DmitriyMakhnovskiy/Digital_BH-meter_NI_DAQ/Design gallery/IMG_20190630_193011_20190701_181841477.jpg

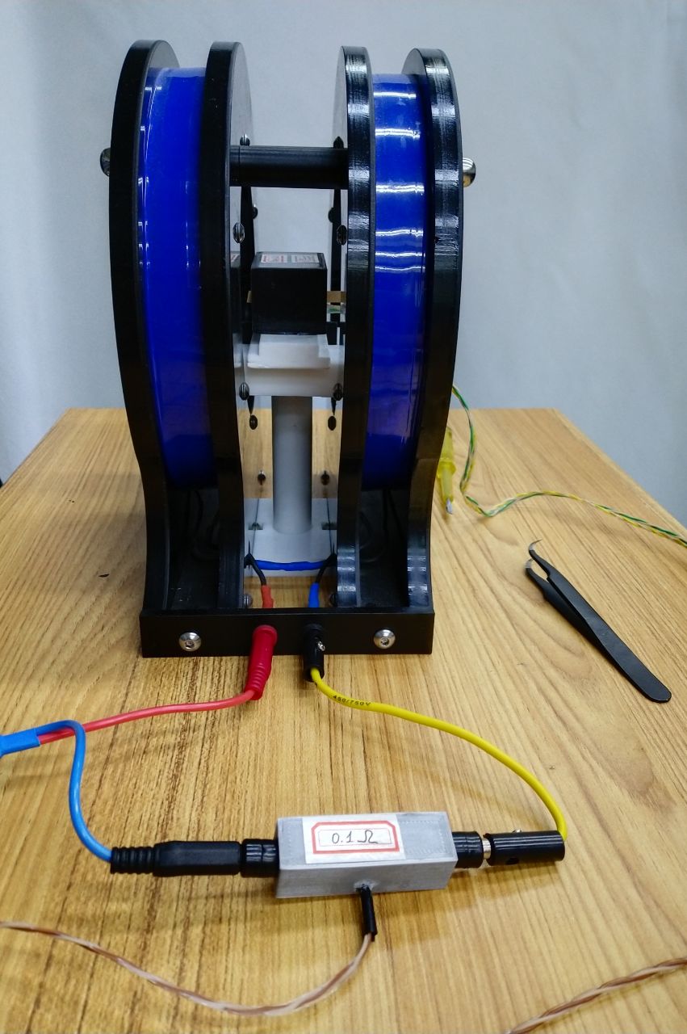
Design gallery/IMG_20190630_193011_20190701_181841477.jpg
