DmitriyMakhnovskiy/Digital_BH-meter_NI_DAQ/Pickup coil design and selection of the devices/Pickup coil design and selection of the devices.pdf

Dmitriy Makhnovskiy | Sensing Materials Technology Ltd, UK | 02.12.2018
1 | P a g e

# Pickup coil design and selection of the devices

## Contents

2 | P a g e

## Measurement setup

The measurement setup for a typical inductive BH looper is shown in Fig. 1. It includes an excitation coil (Helmholtz or solenoid), and two identical solenoidal pickup coils. A current

I
(A; SI units) passed
through the excitation coil induces the magnetising force
H

(Am⁻¹
; SI units) around the pickup coils:
H t | I t ( ) | ( ) =α

(1)

where

α

is a proportionality coefficient (m⁻¹ when using SI units).

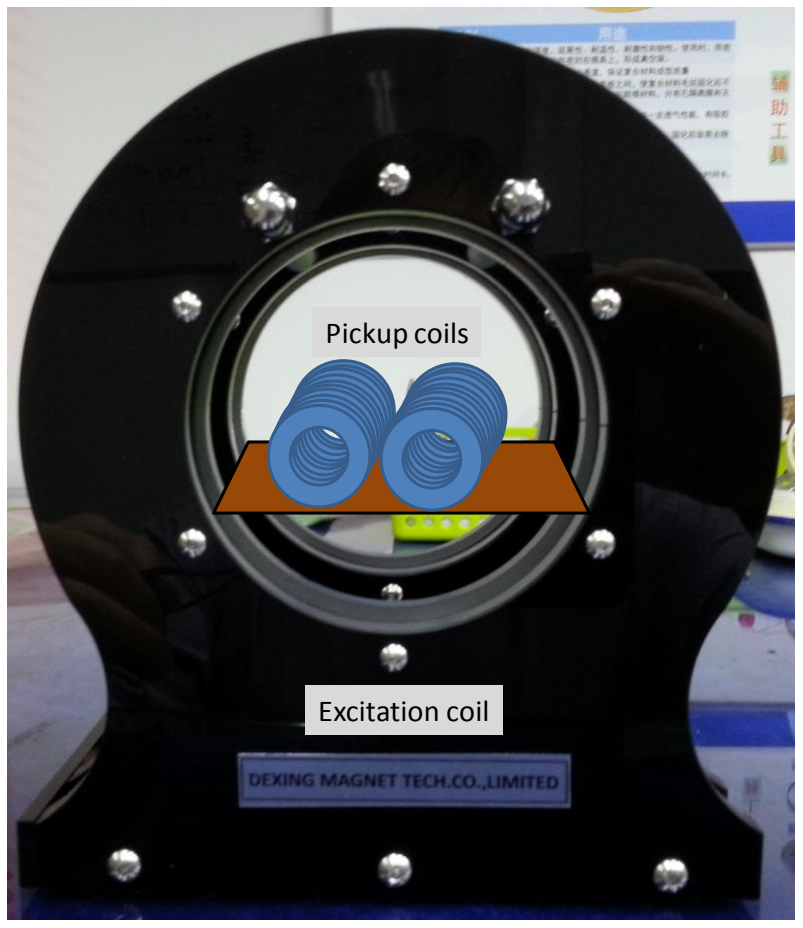
[picture p3: figure]
Excitation coil; Pickup coils

Fig. 1. Measurement setup for an inductive BH looper.

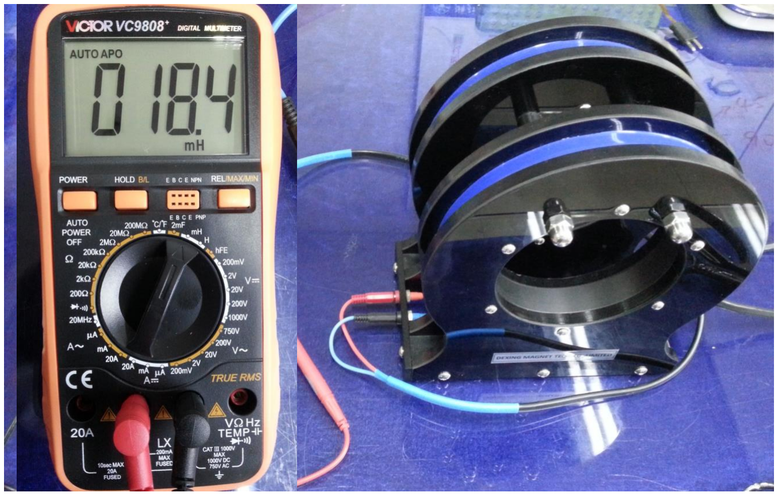
[picture p4: figure]
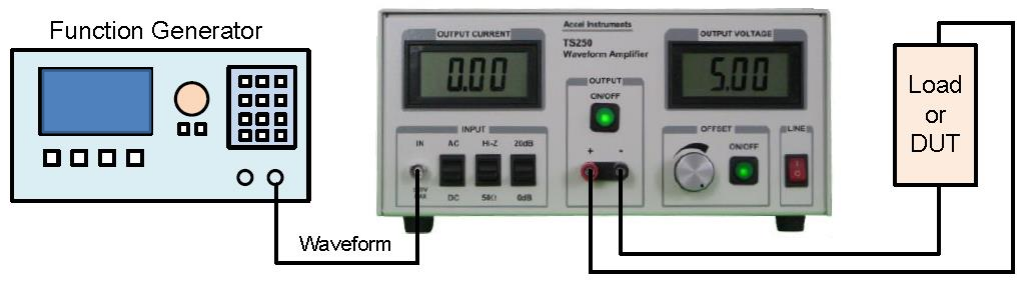
[picture p5: figure]

3 | P a g e

The coil parameters, including its resistance and inductance, can be measured using a digital multimeter (DMM), as shown in Fig. 2.

Fig. 2. Measurement of the coil inductance using a DMM.

## Non-resonant excitation method

In the non-resonant method, the excitation coil (LOAD or DUT), having a resistance

R
(Ω; SI units)
and an inductance

L
(H; SI units), will be connected directly to the waveform amplifier TS250-2 from Accel Instruments (https://www.accelinstruments.com/index.html), as shown in Fig. 3. The waveform will be supplied by our Rohde&Schwartz function generator having the maximum output 10 V at the 50 Ω BNC port.

Fig. 3. Non-resonant excitation method.

4 | P a g e

The main parameters of TS250-2:

- Maximum input voltage ±20 V
- Maximum output voltage ±30 V
- Maximum output currents DC ±2.1 A and AC ±3.0 A (peak)
- Maximum operation frequency 75 kHz
- Voltage gains 1 and 10

For a harmonic excitation voltage

0 V t | V | i t ( ) | exp( | ) = | − ω
, we obtain from (1):

0

exp( | ) () | V | i t Ht
R i L
α | ω ω −
=
+

(2)

where

ωπ = 2 f | is the angular frequency (rads⁻¹
; SI units), V0
is the voltage amplitude (V; SI units), R i L + ω

is the coil impedance. For the selected TS250-2, the maximum amplitude is

0V = 30
V. Let us note that (2) is

true only for a constant or harmonic excitation voltage. In general case, It()

can be expressed through

Vt()
using a convolution.

For the amplitude of the magnetising force (Am⁻¹ ; SI units), we obtain:

-1
| 0
0
2 | 2

[m ]

( ) V
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
3 | -1
| 0
0
2 | 2
10 | [OeA ]
4 | ( | ) V
H
R L

α

π | ω

=
+

(4)

if the excitation coil was calibrated with

-1 α[m ]
or

-1 α[OeA ]
respectively. Using Faraday’s law, for the

voltage

vt()
induced in a one-layer pickup coil, we obtain:
2 | 2 | 2
0 | 0 | 0 ( ) | ( ) | ( ) ( ) | exp( | )
4 | 4 | 4( | )
d | t | D N dB t | D N | dH t | D NV v t | N | i | i t
dt | dt | dt | R i L
π | π | µ | αµ π | ω
ω
ω

Φ
= − | = − | = − | × | = | −
+

(5)

-1
0 | 0 | 2
0
2 | 2
[m ] | ( ) |
4 | ( | )

V
v | v t | ND
R | L
α | µ π ω
| ω
= | =
+

(6)

or

4 | -1
0 | 2
0
2 | 2
10 | [OeA ]
4 | ( | )

V
v | ND
R | L
α | π ω

ω

−
=
+

(7)

5 | P a g e

where
Φ

is the magnetic flux (Wb; SI units) through the pickup coil,
0

v
is the amplitude of the pickup voltage,

N

is the number of turns in the layer,

7
µ | π 0
4 | 10⁻
= | ×

(Hm⁻¹
; SI units) is the permeability of vacuum, and D
is the coil frame diameter. In (5), we assumed that the coil is placed in a homogenous magnetic field.

However, for a multilayer pickup coil, the term
ND

in Eqs. (6),(7) must be modified because for each new layer we will have a slightly different diameter. In addition to D

, let us introduce the coil length l

(m;
SI units), the wire diameter

d
(m; SI units), and the number of fully occupied layers

Nl
. Then, for the number
of turns in each layer we obtain:

N l d = [ / ]
, where the square brackets mean rounding to the integer. Each

layer will add a gradually increasing e.m.f. (from layer to layer) to the total voltage output. So, instead of

2 D
in (6),(7) we have to use the following sum (https://brilliant.org/wiki/sum-of-n-n2-or-n3/):
( | ) | ( | )
1 | 1
2 | 2 | 2 2
0 | 0
1 | 1 | 1
2 | 2 | 2
0 | 0 | 0
| | 2
2
2

2

2

( | 1) | ( | 1)(2 | 1) 1
6
l | l
l | l | l
N | N
n | n
N | N | N
n | n | n
l | l | l
l
D nd | D | Ddn n d
D | Dd | n d | n
d N | d N | N ND
D | D
− | −
= | =
− | − | −
= | = | =
+ | = | + | + | =
æ | ö
= | + | + | = ç | ÷
è | ø
æ | ö − | − | −
= | + | + ç | ÷
è | ø
∑ | ∑
∑ | ∑ | ∑
(8)

Submitting (8) and

N l d = [ / ]
into (6),(7), we obtain for the pickup voltage output:
-1 | | 2
0 | 0 | 2
0
2 | 2 | 2
[m ] | ( | 1) | ( | 1)(2 | 1) | ( ) | | 1
4 | ( | ) | 6
l | l | l
l
V | l | d N | d | N | N v | v t | N D
R | L | d | D | D
α | µ π ω

ω

éù | æ | ö − | − | −
= | = | + | + ç | ÷ êú | ç | ÷
+ | ëû | è | ø

(9)

or

4 | -1 | 2
0 | 2
0
2 | 2 | 2
10 | [OeA ] | ( | 1) | ( | 1)(2 | 1) 1
4 | ( | ) | 6
l | l | l
l
V | l | d N | d | N | N v | N D
R | L | d | D | D
α | π ω

ω

−

éù | æ | ö − | − | −
= | + | + ç | ÷ êú | ç | ÷
+ | ëû | è | ø

(10)

where

[ / ] l
l d N

is the total number of turns in a multilayer pickup coil. Using (8), we can introduce the effective diameter of the pickup coil that must be used for calculating its voltage output together with the total number of turns

[ / ] l
l d N

:

2

2

( | 1) | ( | 1)(2 | 1) 1
6
l | l | l
eff
d N | d | N | N D | D
D | D
− | − | −
= | + | +

(11)

For
Nl =1

, we obviously have

D | D eff = | .

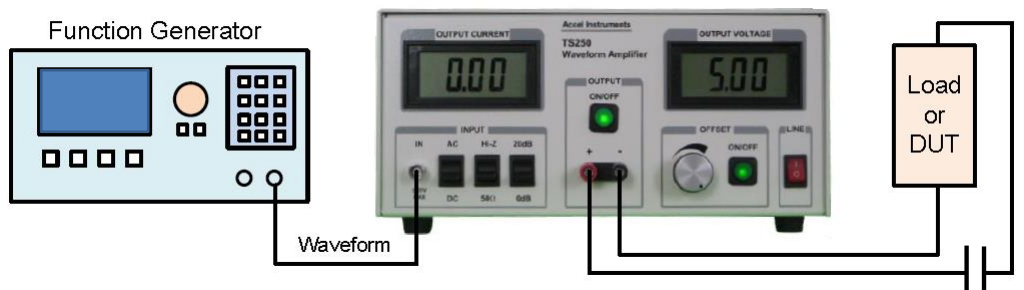
[picture p6: figure]

6 | P a g e

## Resonance excitation

In the resonance excitation method shown in Fig. 4, an additional capacitor C

(Farad; Si units) is
connected in series with the coil to compensate the inductive part of its impedance:

1
Z R i L ()
C
ω | ω
ω
æ | ö
= + | − ç | ÷ è | ø

(12)

The current resonance condition means that

1/ | 0 L | C ω | ω res | res
− | =
:

1
res | LC
ω | =

(13)

At the resonance, the coil impedance becomes purely real

( | ) Z | R ωres
= .

Fig. 4. Resonance excitation method with an additional capacitor connected in series with the coil.

Further reading: https://www.accelinstruments.com/Applications/WaveformAmp/Electromagnetic-Coil-Resonant.html (https://www.accelinstruments.com/Applications/WaveformAmp/Electromagnetic-Coil-Resonant.html)

Using (9),(10), we obtain at the resonance condition:

-1 | 2
0 | 0 | 2
0 | 2
[m ] | ( | 1) | ( | 1)(2 | 1) 1
4 | | | | 6
l | l | l
l
V | l | d N | d | N | N v | N D
R | d | D | D
α | µ π ω éù | æ | ö − | − | −
= | + | + ç | ÷ êú | ç | ÷ ëû | è | ø
(14)

or

4 | -1 | 2
0 | 2
0 | 2
10 | [OeA ] | ( | 1) | ( | 1)(2 | 1) 1
| 4 | | | | 6
l | l | l
l
V | l | d N | d | N | N v | N D
R | d | D | D
α | π ω ⁻
éù | æ | ö − | − | −
= | + | + ç | ÷ êú | ç | ÷ ëû | è | ø
(15)

C

7 | P a g e

Other parameters:

-1
0
0

[m ]V
H
R

α
=
(14)

or

3 | -1
0
0
10 | [OeA ]
| 4 V
H
| R

α
π

=

(15)

0 | 0 | res
C
res
V | V L V
RC | R ω
ω
= | =

(16)

2

1

res

C
Lω

=

(17)

where

VC
is the voltage amplitude across the capacitor. The magnitude of

VC
is important to select the proper voltage rate (kV) of the capacitor. We will use high voltage capacitors.

## Performance of the excitation and pickup coils vs frequency

The algorithm in Fortran used for analysing the excitation and pickup coils is shown below. It was compiled as a console application (PickupCoil.exe) and combines all equations derived above.

### Fortran code

INTEGER flag,i,N,Nl
DOUBLE PRECISION pi,R,L,V0,v,vind,vres,maxf,f,df,mu0,Z,Iex DOUBLE PRECISION VC,C,a,H1,H2,D,lc,dw,startfres,stopfres PARAMETER(pi=3.1415926535897932384626433832795, N=5000)

mu0=4.0*pi*1.0E-7

WRITE(*,*)'Enter the resistance of the excitation coil (Ohm).' READ(*,*) R
WRITE(*,*)''

WRITE(*,*)'Enter the inductance of the excitation coil (mH).' READ(*,*) L
WRITE(*,*)''
L=L*1.0E-3

WRITE(*,*)'Enter the diameter of the pickup coil (mm).' READ(*,*) D
WRITE(*,*)''
D=D*1.0E-3

WRITE(*,*)'Enter the length of the pickup coil (mm).' READ(*,*) lc
WRITE(*,*)''
lc=lc*1.0E-3

8 | P a g e

WRITE(*,*)'Enter the wire diameter used in the pickup coil (mm).' READ(*,*) dw
WRITE(*,*)''
dw=dw*1.0E-3

WRITE(*,*)'Enter the number of layers in the pickup coil.' READ(*,*) Nl
WRITE(*,*)''

WRITE(*,*)'Enter the amplitude of the excitation voltage (V).' READ(*,*) V0
WRITE(*,*)''

WRITE(*,*)'Enter the maximum excitation frequency (Hz).' READ(*,*) maxf
WRITE(*,*)''

WRITE(*,*)'Enter the start resonance frequency (Hz).' READ(*,*) startfres
WRITE(*,*)''

WRITE(*,*)'Enter the stop resonance frequency (Hz).' READ(*,*) stopfres
WRITE(*,*)''

df=maxf/N
OPEN(10,FILE='Excitation_coil_impedance.CSV') WRITE(10,*)'Hertz',',','Ohm'
DO i=0,N
f=df*i
Z=DSQRT(R**2+(2.0*pi*f*L)**2) WRITE(10,100) f,Z
END DO
CLOSE(10)
100 | FORMAT(F20.8,',',F20.8)
| df=(stopfres-startfres)/N
| OPEN(20,FILE='Resonance_capacitor.CSV')
| WRITE(20,*)'Hertz',',','Farad',',','V across C'
| DO i=0,N
| f=startfres+df*i
| C=1.0/(L*(2.0*pi*f)**2)
| VC=V0*L*2.0*pi*f/R
| WRITE(20,200) f,C,VC
| END DO
| CLOSE(20)
200 | FORMAT(F20.8,',',F20.20,',',F20.8)
| WRITE(*,*)'Units for the coil calibration coefficient H=a*I:'
| WRITE(*,*)'Enter 1 for a[1/m]'
| WRITE(*,*)'Enter 2 for a[Oe/A]'
| READ(*,*) flag
| WRITE(*,*)''

9 | P a g e

df=maxf/N

OPEN(25,FILE='Excitation_current.CSV') WRITE(25,*)'Hz',',','A'
DO i=0,N
f=df*i
Iex=V0/DSQRT(R**2+(2.0*pi*f*L)**2) WRITE(25,250) f,Iex
END DO
CLOSE(25)
250 | FORMAT(F20.8,',',F20.8)
c | *********************************************
| SELECT CASE(flag)
| CASE(1)
| WRITE(*,*)'Enter the coil calibration coefficient (1/m)'
| READ(*,*) a
| WRITE(*,*)''
| df=maxf/N
| OPEN(30,FILE='Scanning_field.CSV')
| WRITE(30,*)'Hz',',','A/m',',','Oe'
| DO i=0,N
| f=df*i
| H1=a*V0/DSQRT(R**2+(2.0*pi*f*L)**2)
| H2=H1*4.0*pi/1000.0
| WRITE(30,300) f,H1,H2
| END DO
| CLOSE(30)
300 | FORMAT(F20.8,',',F20.8,',',F20.8)
| OPEN(40,FILE='Pickup_voltage.CSV')
| WRITE(40,*)'Hz',',','vind',',','vres'
| DO i=0,N
| f=df*i
| v=a*mu0*pi*V0*2.0*pi*f*DINT(lc/dw)*Nl*D**2/4.0
| v=v*(1.0+dw*(Nl-1)/D+dw**2*(NL-1)*(2*Nl-1)/(6.0*D**2))
| vind=v/DSQRT(R**2+(2.0*pi*f*L)**2)
| vres=v/R
| WRITE(40,400) f,vind,vres
| END DO
| CLOSE(40)
400 | FORMAT(F20.8,',',F20.8,',',F20.8)
| CASE(2)
| WRITE(*,*)'Enter the coil calibration coefficient (Oe/A)'
| READ(*,*) a
| WRITE(*,*)''

10 | P a g e

df=maxf/N

OPEN(50,FILE='Scanning_field.CSV') WRITE(50,*)'Hz',',','A/m',',','Oe'
DO i=0,N
f=df*i
H2=a*V0/DSQRT(R**2+(2.0*pi*f*L)**2) H1=H2*1000.0/(4.0*pi)
WRITE(50,500) f,H1,H2
END DO
CLOSE(50)
500 | FORMAT(F20.8,',',F20.8,',',F20.8)
| OPEN(60,FILE='Pickup_voltage.CSV')
| WRITE(60,*)'Hz',',','vind',',','vres'
| DO i=0,N
| f=df*i
| v=1.0E-4*a*pi*V0*2.0*pi*f*DINT(lc/dw)*Nl*D**2/4.0
| v=v*(1.0+dw*(Nl-1)/D+dw**2*(NL-1)*(2*Nl-1)/(6.0*D**2))
| vind=v/DSQRT(R**2+(2.0*pi*f*L)**2)
| vres=v/R
| WRITE(60,600) f,vind,vres
| END DO
| CLOSE(60)
600 | FORMAT(F20.8,',',F20.8,',',F20.8)
| END SELECT
| OPEN(70,FILE='Coil_parameters.txt')
| WRITE(70,*)'Excitation coil resistance (Ohm) = ',R
| WRITE(70,*)'Excitation coil inductance (mH) = ',L*1000.0
| WRITE(70,*)'Excitation voltage amplitude (V) = ',V0
| WRITE(70,*)''
| WRITE(70,*)'****************************************************'
| WRITE(70,*)''
| WRITE(70,*)'Pickup coil diameter (mm) = ',D*1000.0
| WRITE(70,*)'Pickup coil length (mm) = ',lc*1000.0
| WRITE(70,*)'Pickup coil wire diameter (mm) = ',dw*1000.0
| WRITE(70,*)'Number of layers = ',Nl
| WRITE(70,*)'Turns in each layer = ',DINT(lc/dw)
| WRITE(70,*)'Total turns = ',Nl*DINT(lc/dw)
| WRITE(70,*)'Total diameter (mm) = ',(D+2*NL*dw)*1000.0
| CLOSE(70)
| STOP

END

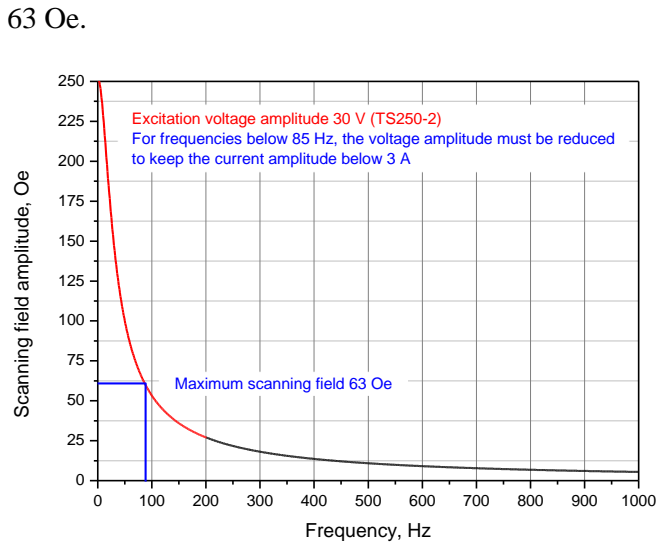
[picture p7: figure]
Maximum scanning field 63 Oe; Frequency, Hz

11 | P a g e

### Small Helmholtz coil – low frequency BH-loops

The pickup coils will be designed for two Dexing Helmholtz excitation coils we already have in the laboratory:

- “Small coil” (shown in Fig. 1)
o

R = 2.5 Ω
o

L =18.4

mH
o

a = 21

Oe/A
- “Large coil” (used for MI measurements)
o

R = 8.38 Ω
o

L = 320

mH
o

a = 35.95

Oe/A

Our analysis shows that the small excitation coil cannot be used for the resonance excitation because its inductance is quite small that results in a large compensation capacitor required to provide the resonance condition (13) for reasonable frequencies. So, this coil will be used only for low frequency BH-loops with the excitation scheme in Fig. 3. In Fig. 5, the frequency performance of the coil is shown calculated for

0V = 30
V (maximum output voltage for the waveform amplifier TS250-2). Up to 200 Hz, the coil can provide enough fields to scan ferromagnetic wires. For frequencies below 85 Hz, the amplifier output

V0
must be reduced to
keep the AC current amplitude below 3 A for TS250-2. So, the maximum scanning field will be no more than

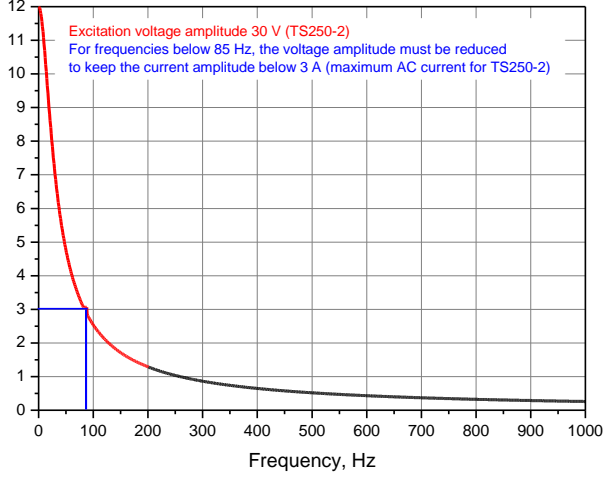
[picture p8: figure]
Frequency, Hz

Fig. 5. Frequency performance of the small Helmholtz coil (shown in Fig. 1).

At the same time, we must obtain a detectable voltage at the pickup coils. The coil geometrical parameters are dictated by the size of the Helmholtz coil. We chose the following dimensions for the pickup coils:

- Diameter – 10 mm
- Length – 30 mm

Excitation voltage amplitude 30 V (TS250-2) For frequencies below 85 Hz, the voltage amplitude must be reduced

to keep the current amplitude below 3 A Scanning field amplitude, Oe

# 12 Excitation current amplitude, A

Excitation voltage amplitude 30 V (TS250-2) For frequencies below 85 Hz, the voltage amplitude must be reduced

to keep the current amplitude below 3 A (maximum AC current for TS250-2)

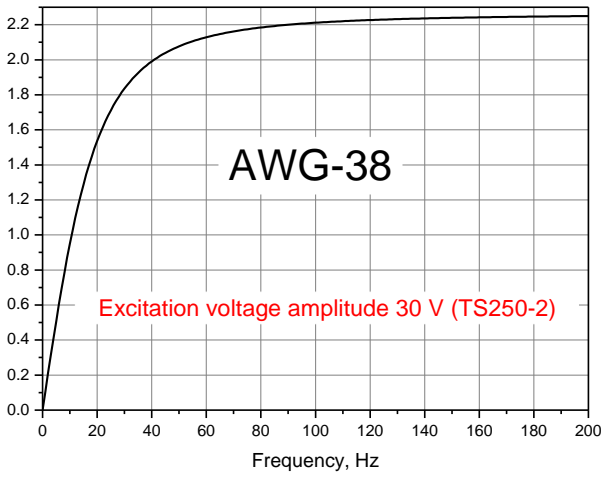
[picture p9: figure]
AWG-38; Frequency, Hz

12 | P a g e

For reasons of the field uniformity inside the Helmholtz coil, the width of the assembly of two pickup coils must not exceed 40 mm. We tried two pickup coil designs with the wire windings made of AWG-38 and AWG-40 (https://en.wikipedia.org/wiki/American_wire_gauge):

- Wire diameter together with the enamel coating – 0.109788 mm (copper wire AWG-38)
- Number of layers – 30
- Turns in each layer – 273
- Total number or turns – 8190
- Total diameter (30 layers) – 17 mm
- Wire diameter together with the enamel coating – 0.087059 mm (copper wire AWG-40)
- Number of layers – 40
- Turns in each layer – 344
- Total number or turns – 13760
- Total diameter (40 layers) – 17 mm

The pickup voltage amplitudes vs. frequency calculated for the two coil designs with the wire windings made of AWG-38 and AWG-40 are shown in Fig. 6. Both designs are acceptable, but we should prefer the wire winding made of AWG-40 because it provides a larger voltage output.

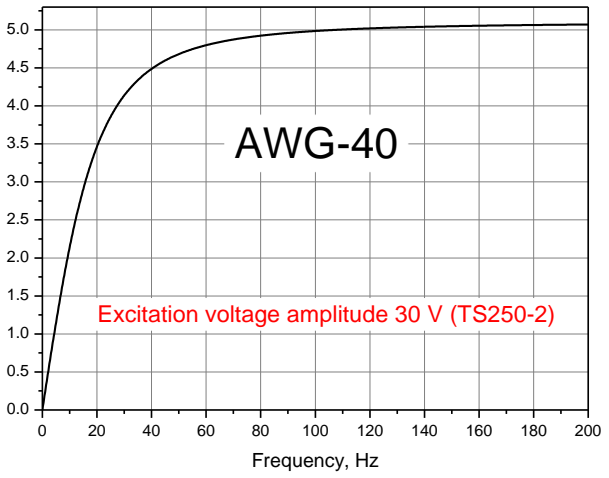
[picture p10: figure]
Frequency, Hz; AWG-40

Fig. 6. Pickup voltage amplitudes vs. frequency calculated for the two coil designs with the wire windings made of AWG-38 and AWG-40.

To use the inductive excitation method (Fig. 3) for higher frequencies, we will need a lighter Helmholtz coil. Ideally, with two Helmholtz coils (“small” and “large”) we should cover both low and high frequency BH loops. For the coils we currently have, there will be a gap in the excitation frequencies.

Excitation | voltage amplitude 30 | V (TS250-2) Pickup voltage amplitude, V
Excitation | voltage amplitude 30 | V (TS250-2) Pickup voltage amplitude, V

13 | P a g e

### Large Helmholtz coil – resonance excitation and high frequency BH-loops

For the resonance excitation scheme shown in Fig. 4, we can use the large Helmholtz coil (currently used for MI measurements). The amplitude of the excitation voltage must be reduced to

0V = 25
V to
guarantee
0
I V R = | = | ≈ / | 25 / 8.38 3

A – maximum current amplitude for the waveform amplifier TS250-2. The coil inductance is 320 mH.

Let us start the design looking at the frequency dependence of the voltage amplitude

VC
across the

capacitor shown in Fig. 7. From this graph we can see that

VC
may reach 50 kV. So, a high voltage (HV) capacitor will be required for the LC resonance circuit. Potential suppliers of the HV capacitors:
- http://www.avx.com/products/ceramic-capacitors/high-voltage/hdhe-type/
- http://www.vishay.com/capacitors/ceramic/high-voltage/
- http://www.kemet.com/High-Volt-MLCC
- http://www.calramic.com/CalRamic-capacitors-products.html

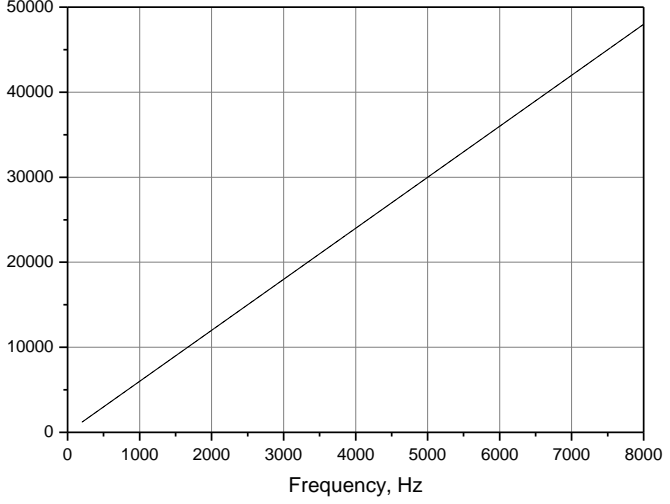
[picture p11: figure]
Frequency, Hz

Fig. 7. The voltage amplitude across the capacitor calculated for

0V = 25
V.

The maximum capacitance of a high voltage capacitor with acceptable dimensions we could find is 45 nF. This capacitor has the voltage rate just 3 kV. Therefore,

V0
must be further reduced, at least three times less, if we want to measure within 1-2 kHz. As a result, the scanning field amplitude will be also reduced. Further reducing the frequency would be unreasonable because the voltage rate decreases when the capacitance increases. So, with our current Helmholtz coils (“small” and “large”) it would be impossible to fill the gap between the low frequency (below 200 Hz) and high frequency (kHz) BH-loop measurements. A lighter coil than our “small” one will be required to extend the low frequency BH-loop measurements with the inductive excitation scheme in Fig. 3.

# 50000 Voltage amplitude across the capacitor, V

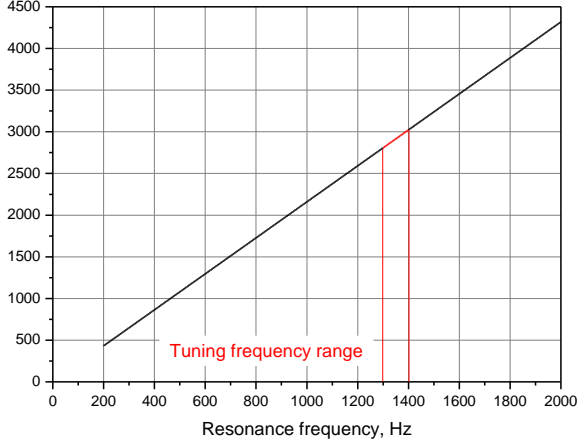
[picture p12: figure]
Resonance frequency, Hz; Tuning frequency range

14 | P a g e

In Fig. 8, we show the performance of the excitation and pickup coils calculated for

0V = 9
V and the
following pickup coil parameters:
- Diameter – 10 mm
- Length – 30 mm
- Wire diameter together with the enamel coating – 0.109788 mm (copper wire AWG-38)
- Number of layers – 6
- Turns in each layer – 273
- Total number or turns – 1638
- Total diameter (6 layers) – 11 mm

The amplitude of the scanning magnetic field will be around 39 Oe:

-1
0 H | a | V R [Oe] | [OeA ] | / =

with
a = 35.95
Oe/A,
0V = 9

V, and
R = 8.38

Ω. Increasing the resonance frequency and decreasing the capacitance (< 45 nF), we can gradually increase the scanning field amplitude because the voltage rate of the capacitor will also increase. The frequency scale must be divided into narrow sectors, for each one an individual pickup coil must be designed. The design we are demonstrating in this section is for
1350 res f ≈

Hz, L = 320

mH,
R = 8.38
Ω, and
C = 45

nF. Starting from a sufficiently high frequency, it would be reasonable to return to the small Helmholtz coil to reduce the voltage
VC

across the capacitor according to (16). However, such high frequencies are probably not of interest for our conductive ferromagnetic wires.

Fig. 8. Performance of the excitation and pickup coils for the selected resonance excitation near 1350 Hz.

# 4500 Voltage amplitude across the capacitor, V

0 | 200 | 400 | 600 | 800 | 1000 | 1200 | 1400 | 1600 | 1800 | 2000

0.00E+000

5.00E-008

1.00E-007

1.50E-007

2.00E-007

2.50E-007

3.00E-007

3.50E-007

4.00E-007

# 4.50E-007 Capacitance, F

Resonance frequency, Hz

L = 320 mH

C < 45 nF

0 | 200 | 400 | 600 | 800 | 1000 | 1200 | 1400 | 1600 | 1800 | 2000

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
Tuning frequency range Pickup voltage amplitude, V

Resonance frequency, Hz

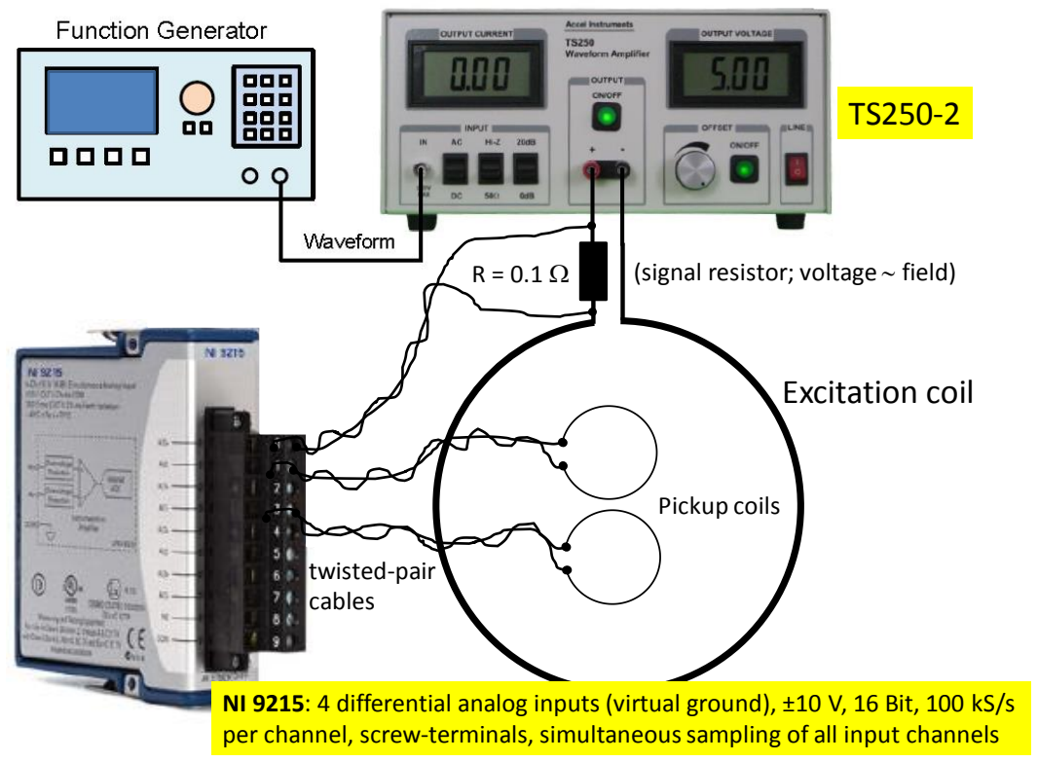
[picture p13: figure]
(signal resistor; voltage ~ field); Excitation coil; Pickup coils; twisted-pair cables

15 | P a g e

## Selecting NI devices

The signal acquisition scheme with is shown in Fig. 9. We have chosen NI 9215 analog input module: 4 differential analog inputs (virtual ground), ±10 V, 16 Bit, 100 kS/s per channel, screw-terminals, simultaneous sampling of all input channels. The voltages from the excitation and pickup coils will be sampled simultaneously – three channels in total. The fourth channel will be reserved. The sampling rate 100 kS/s is more than enough for our applications where the excitation frequencies will not exceed several kHz. The output voltage amplitudes must not exceed 5 V. The module NI 9215 will be inserted into the 1-slot chassis NI cDAQ 9181 with the Ethernet connection shown in Fig. 10.

Fig. 9. Signal acquisition scheme.

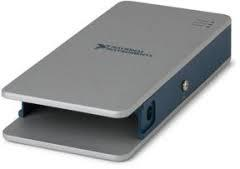
[picture p14: figure]

Fig. 10. 1-slot chassis NI cDAQ 9181.

NI 9215: 4 differential analog inputs (virtual ground), ±10 V, 16 Bit, 100 kS/s per channel, screw-terminals, simultaneous sampling of all input channels
