DmitriyMakhnovskiy/Digital_BH-meter_NI_DAQ/LabVIEW and exe/Screen shorts.docx

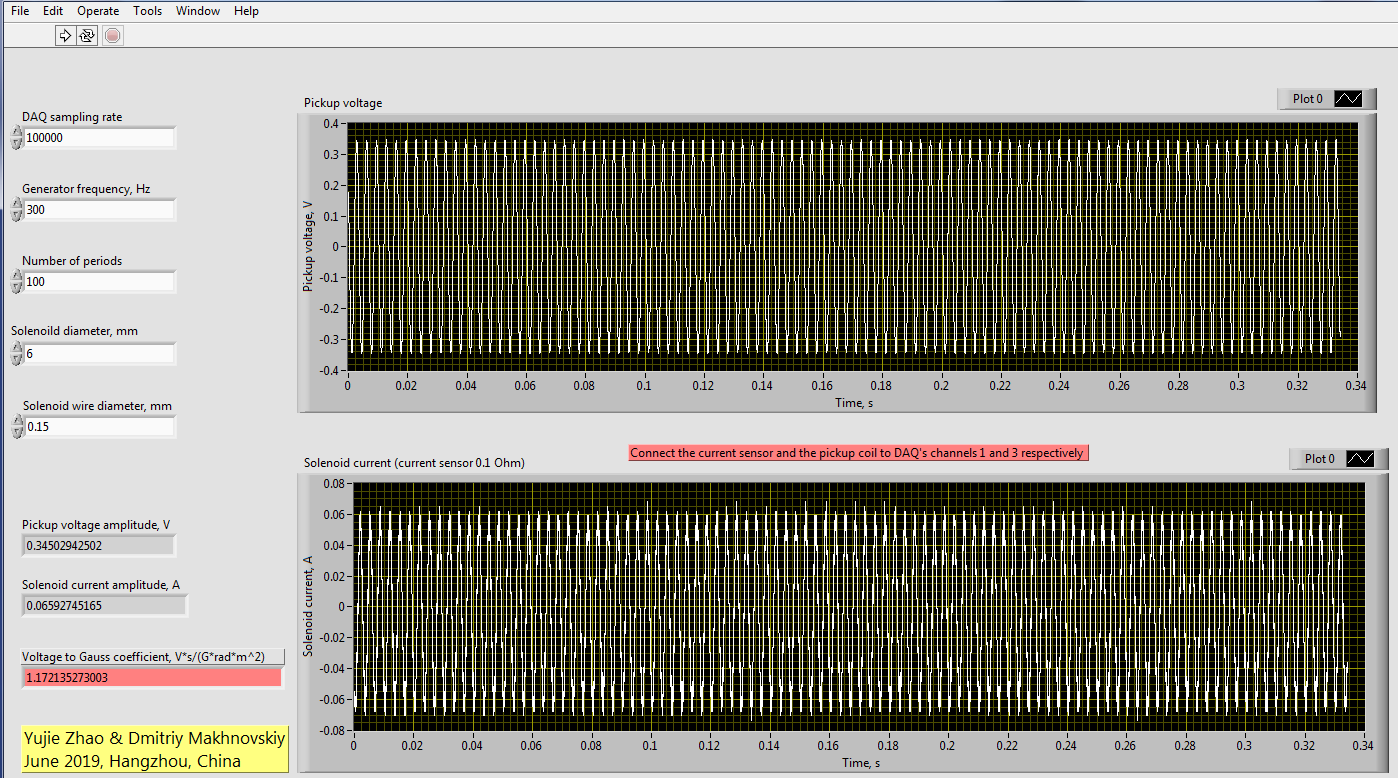
[picture p62: figure]
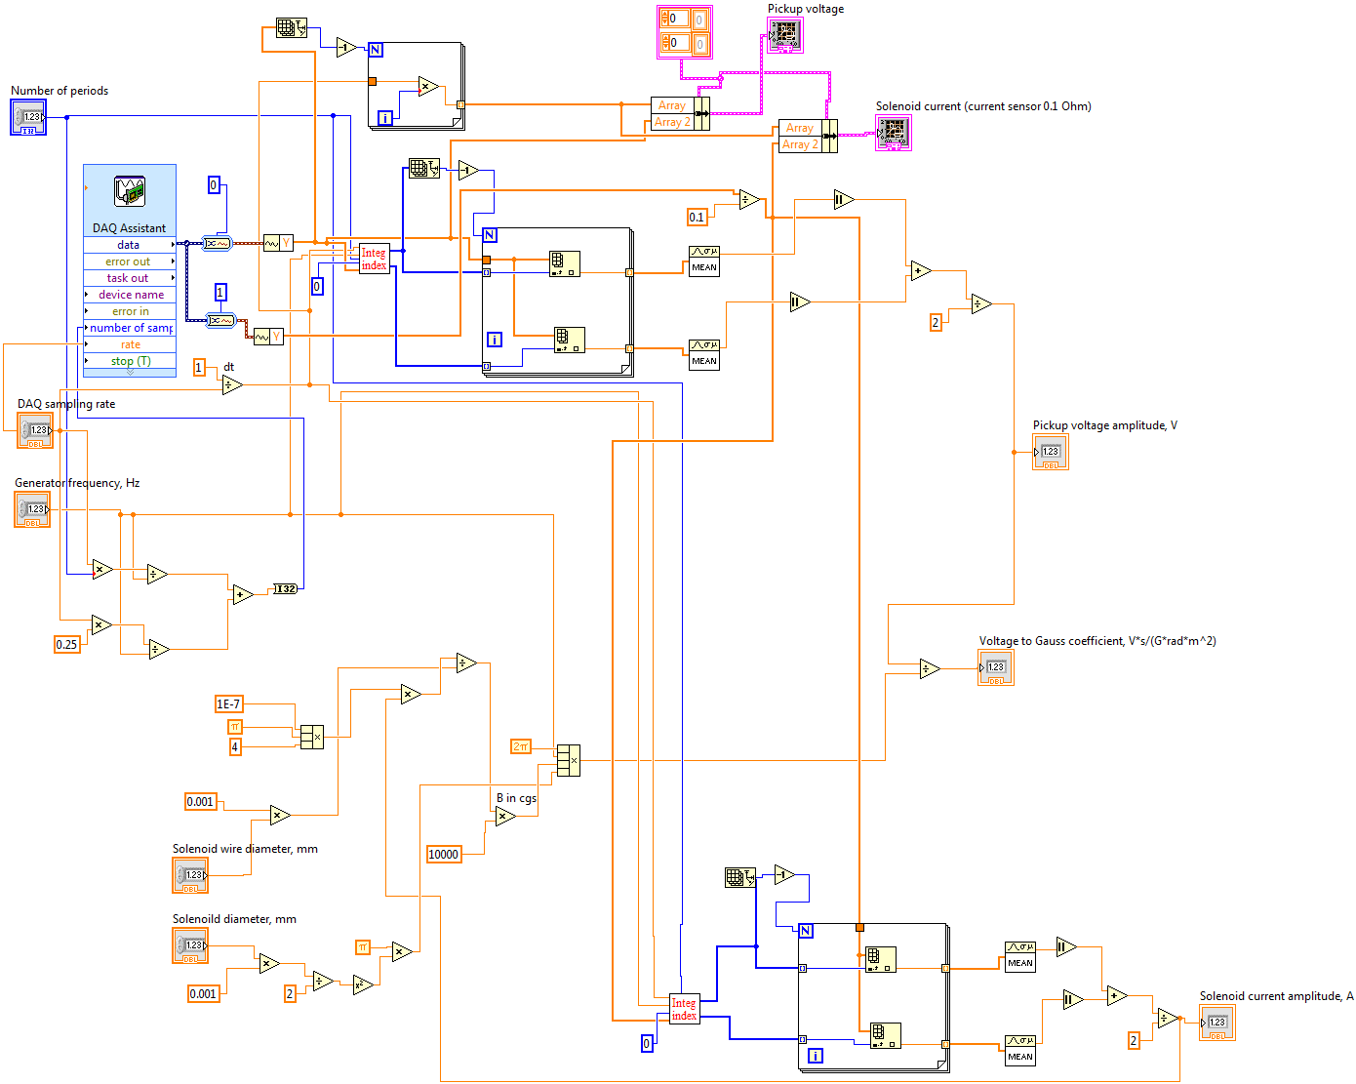
[picture p63: figure]
