DmitriyMakhnovskiy/Digital_BH-meter_NI_DAQ/Design gallery/IMG_7817.JPG

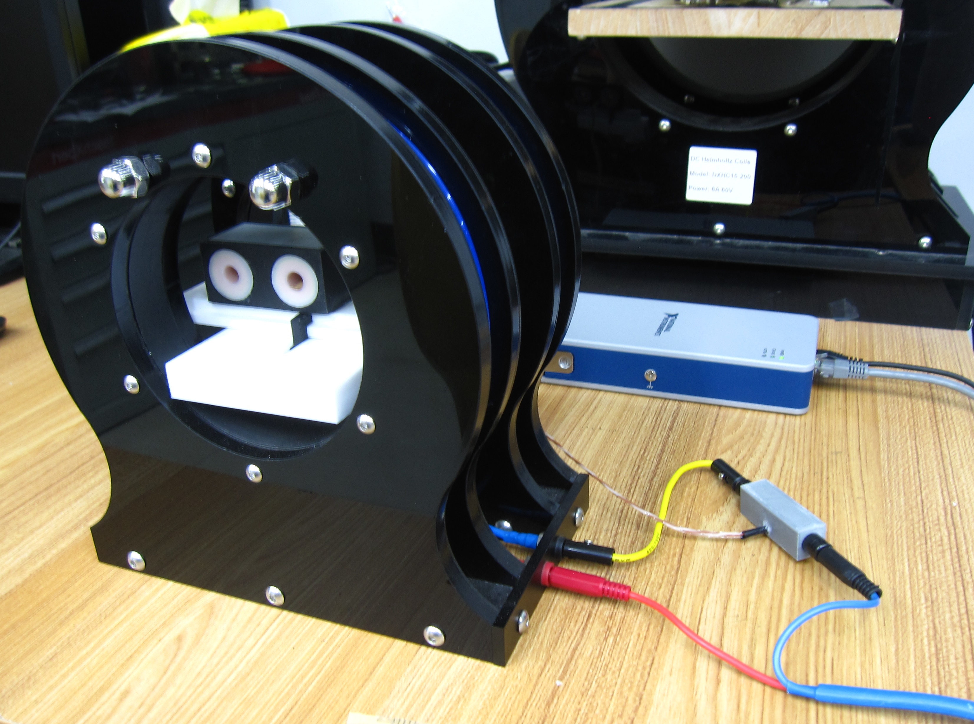
Design gallery/IMG_7817.JPG
