DmitriyMakhnovskiy/Digital_BH-meter_NI_DAQ/Design gallery/IMG_7821.JPG

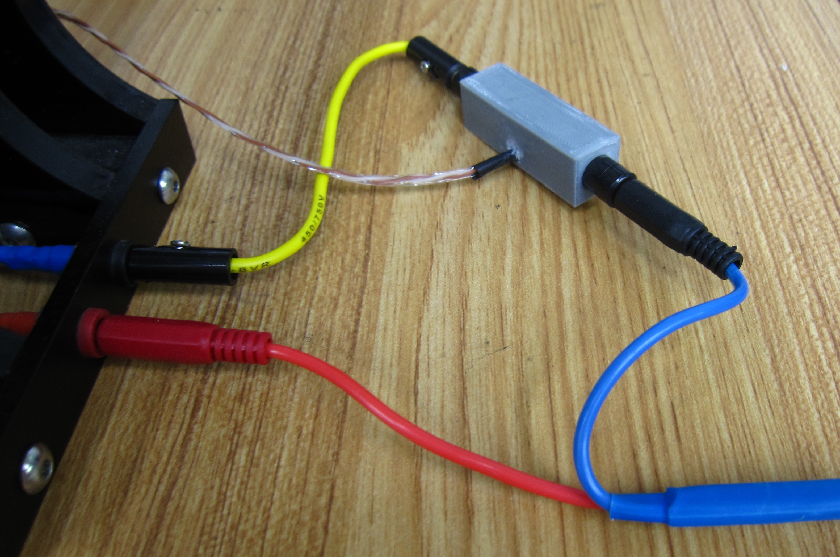
Design gallery/IMG_7821.JPG
