DmitriyMakhnovskiy/Digital_BH-meter_NI_DAQ/Design gallery/IMG_20190530_195148_20190620_160019381.jpg

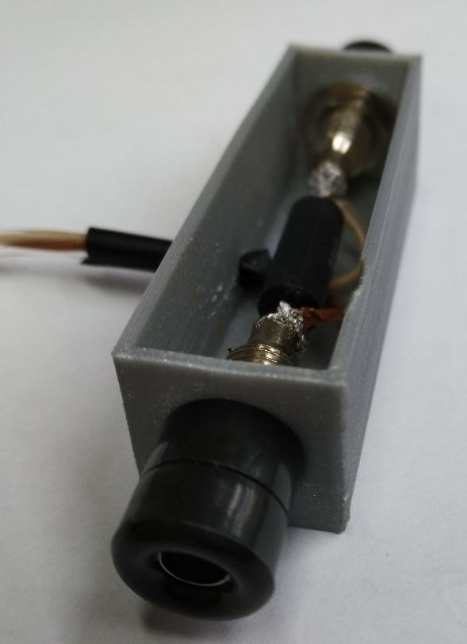
Design gallery/IMG_20190530_195148_20190620_160019381.jpg
