DmitriyMakhnovskiy/Digital_BH-meter_NI_DAQ/Design gallery/IMG_20190530_195252.jpg

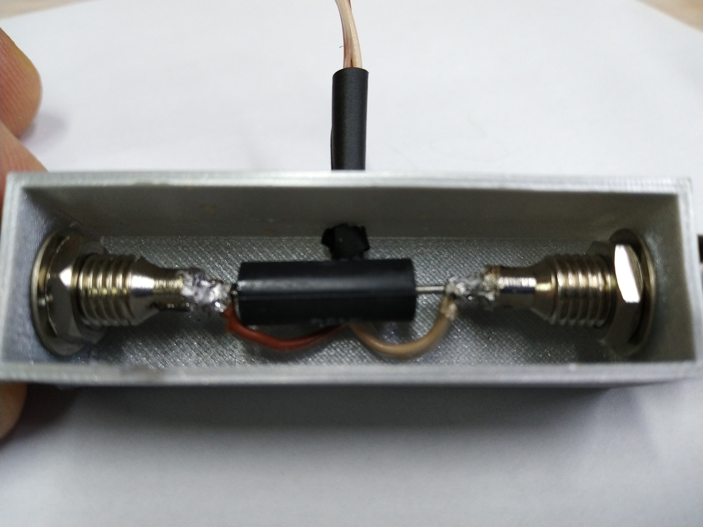
Design gallery/IMG_20190530_195252.jpg
