DmitriyMakhnovskiy/Digital_BH-meter_NI_DAQ/Design gallery/IMG_20190530_195352_20190620_160020149.jpg

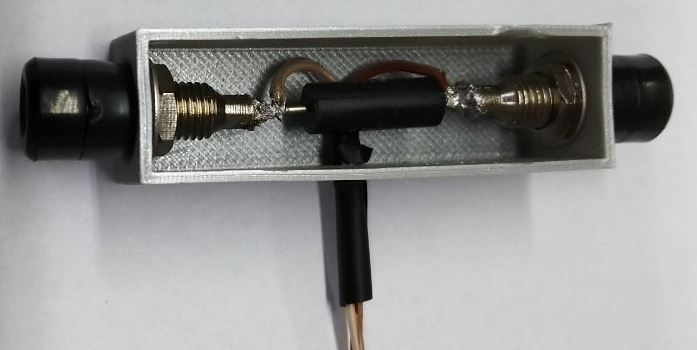
Design gallery/IMG_20190530_195352_20190620_160020149.jpg
