DmitriyMakhnovskiy/Digital_BH-meter_NI_DAQ/Design gallery/IMG_20190530_201949_20190620_160021171.jpg

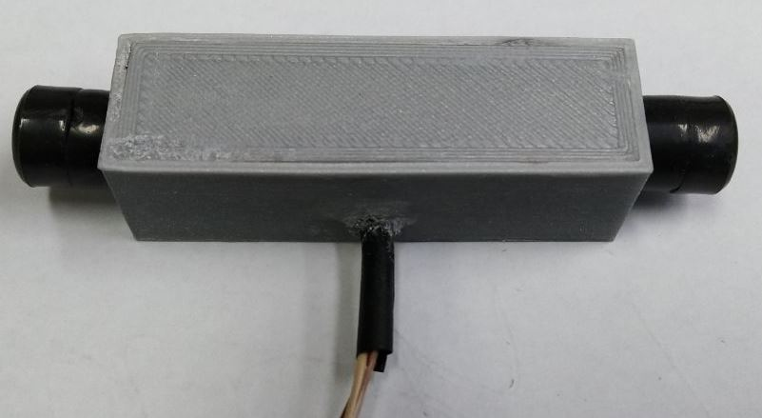
Design gallery/IMG_20190530_201949_20190620_160021171.jpg
