DmitriyMakhnovskiy/Digital_BH-meter_NI_DAQ/Design gallery/IMG_20190530_220149_20190620_160019904.jpg

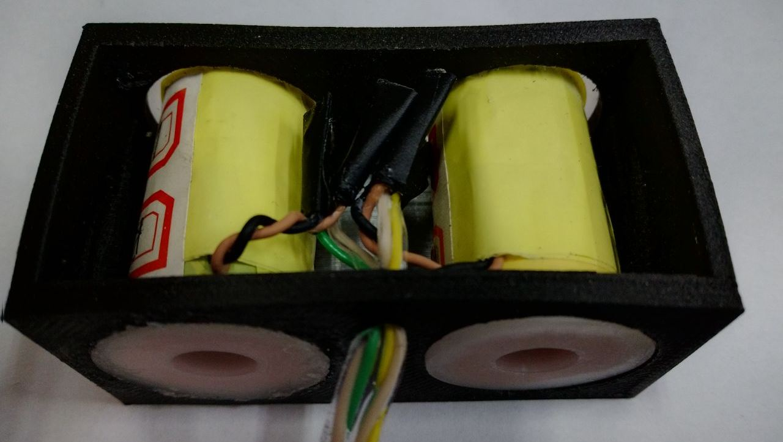
Design gallery/IMG_20190530_220149_20190620_160019904.jpg
