DmitriyMakhnovskiy/Digital_BH-meter_NI_DAQ/Design gallery/IMG_20190530_220203_20190620_160019640.jpg

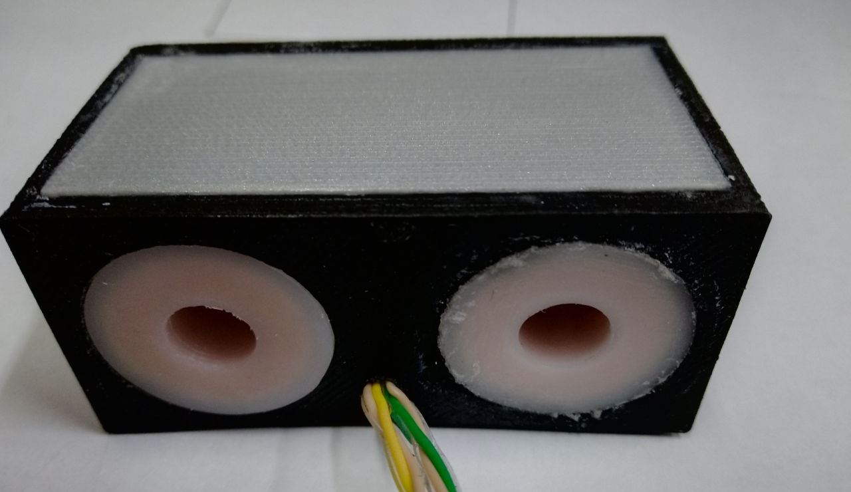
Design gallery/IMG_20190530_220203_20190620_160019640.jpg
