DmitriyMakhnovskiy/Digital_BH-meter_NI_DAQ/Design gallery/IMG_20190530_222730_20190620_160018778.jpg

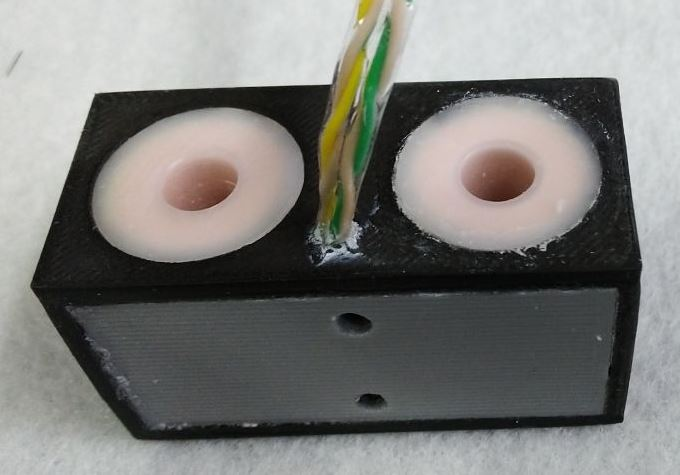
Design gallery/IMG_20190530_222730_20190620_160018778.jpg
