DmitriyMakhnovskiy/Digital_BH-meter_NI_DAQ/Design gallery/IMG_20190530_222744_20190620_160019081.jpg

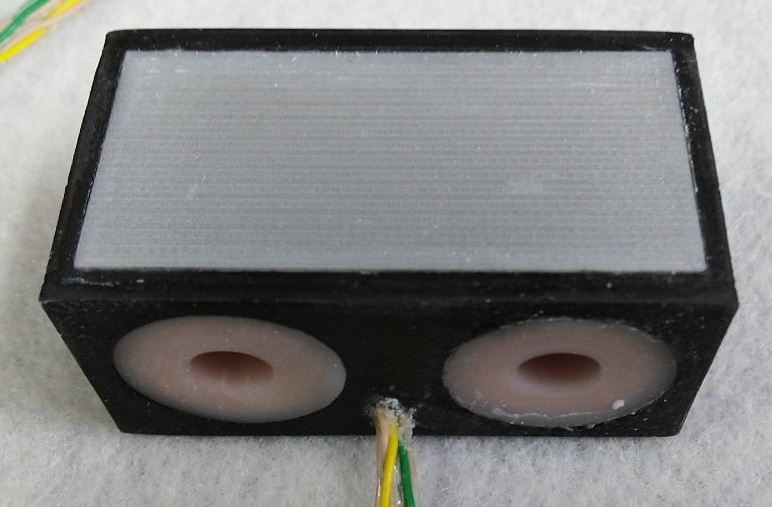
Design gallery/IMG_20190530_222744_20190620_160019081.jpg
