DmitriyMakhnovskiy/Digital_BH-meter_NI_DAQ/Design gallery/IMG_20190530_222753_20190620_160021948.jpg

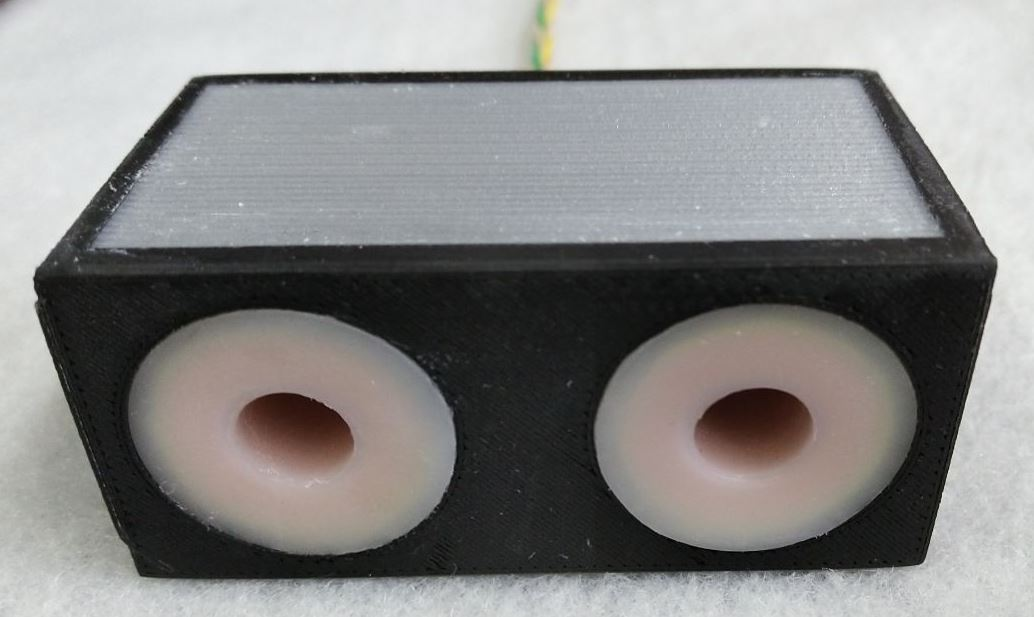
Design gallery/IMG_20190530_222753_20190620_160021948.jpg
