DmitriyMakhnovskiy/Digital_BH-meter_NI_DAQ/Design gallery/IMG_20190628_192138_20190701_184128933.jpg

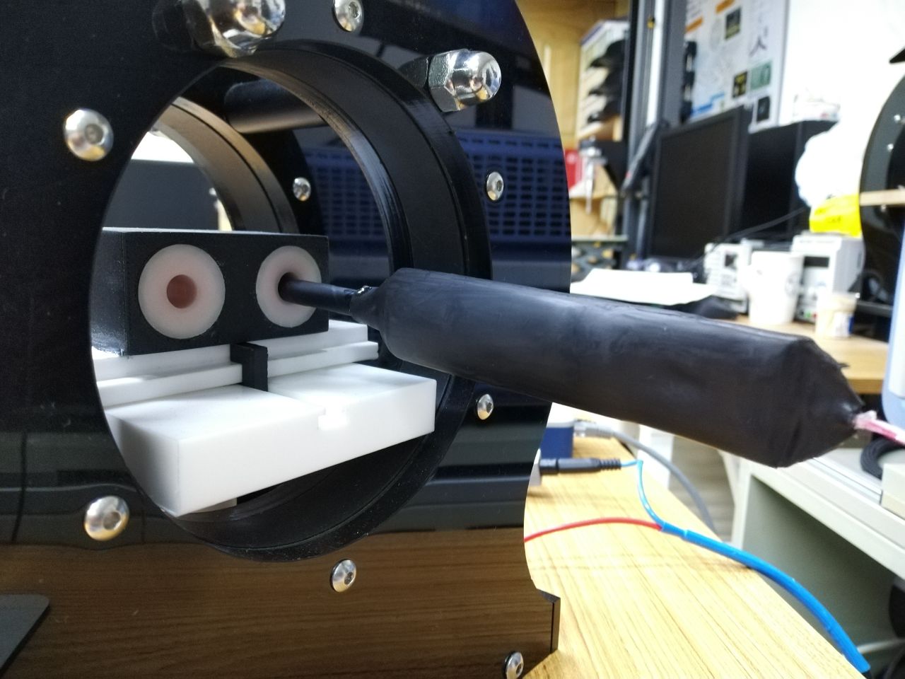
Design gallery/IMG_20190628_192138_20190701_184128933.jpg
