DmitriyMakhnovskiy/Digital_BH-meter_NI_DAQ/Design gallery/IMG_20190628_192229_20190701_184131190.jpg

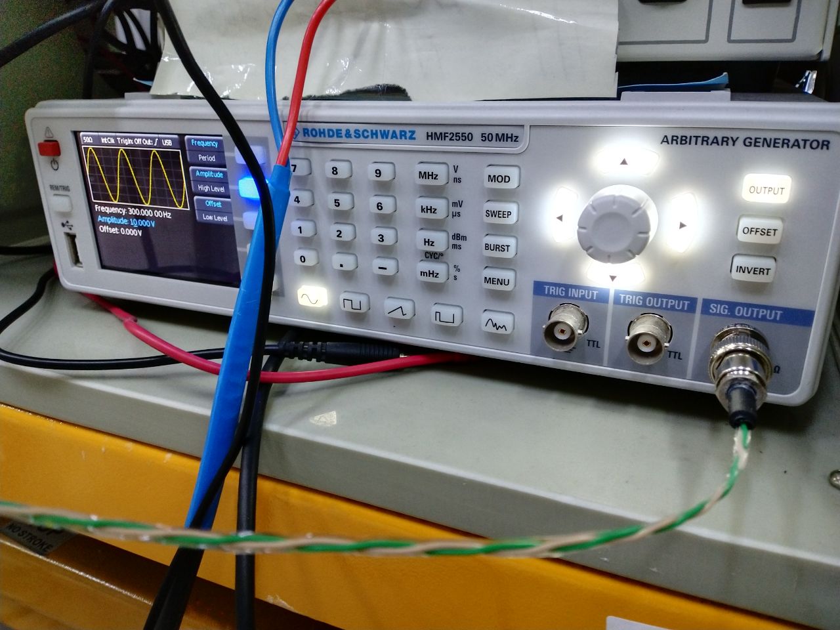
Design gallery/IMG_20190628_192229_20190701_184131190.jpg
