DmitriyMakhnovskiy/Digital_BH-meter_NI_DAQ/Design gallery/IMG_20190628_192318_20190701_184132021.jpg

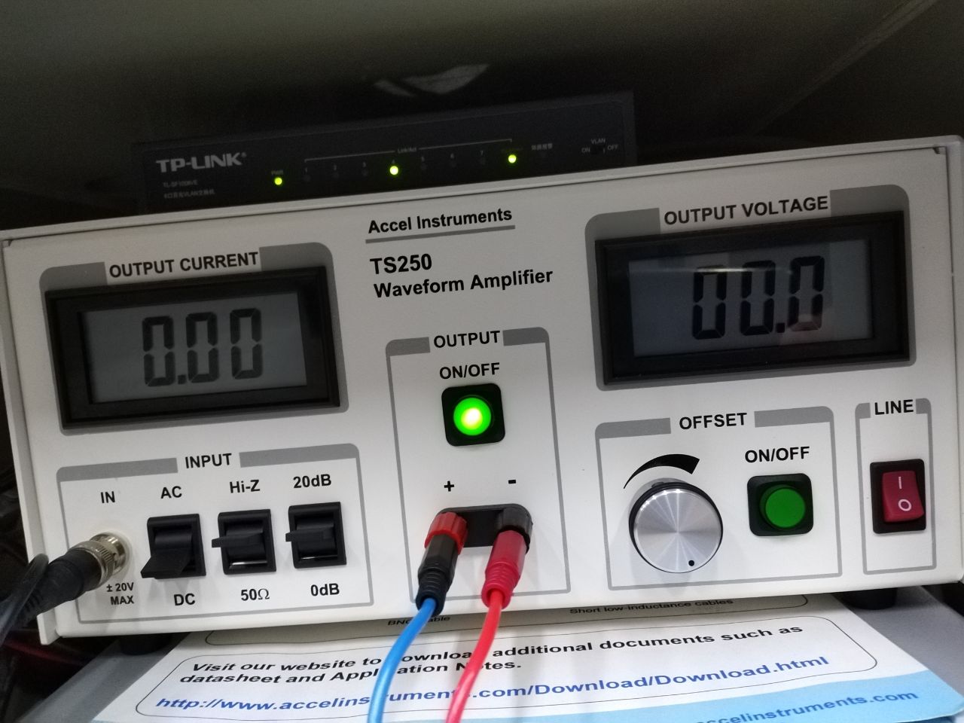
Design gallery/IMG_20190628_192318_20190701_184132021.jpg
