DmitriyMakhnovskiy/Digital_BH-meter_NI_DAQ/Design gallery/IMG_20190628_192332_20190701_184132789.jpg

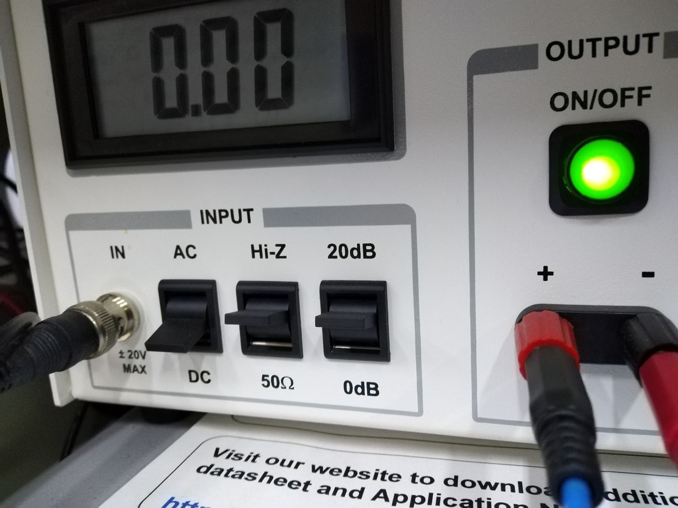
Design gallery/IMG_20190628_192332_20190701_184132789.jpg
