DmitriyMakhnovskiy/Digital_BH-meter_NI_DAQ/Design gallery/IMG_20190629_204543_20190701_184129150.jpg

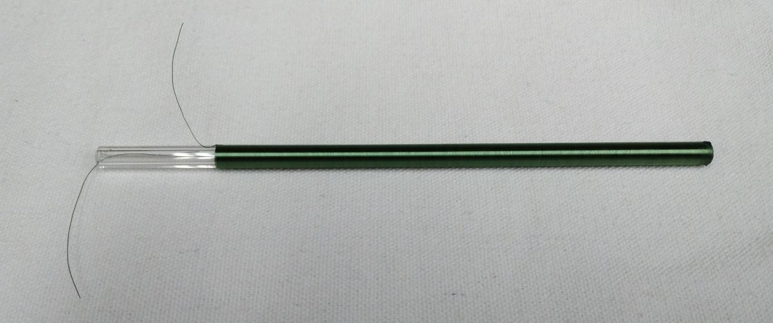
Design gallery/IMG_20190629_204543_20190701_184129150.jpg
