DmitriyMakhnovskiy/Digital_BH-meter_NI_DAQ/Design gallery/IMG_20190629_211728_20190701_184130006.jpg

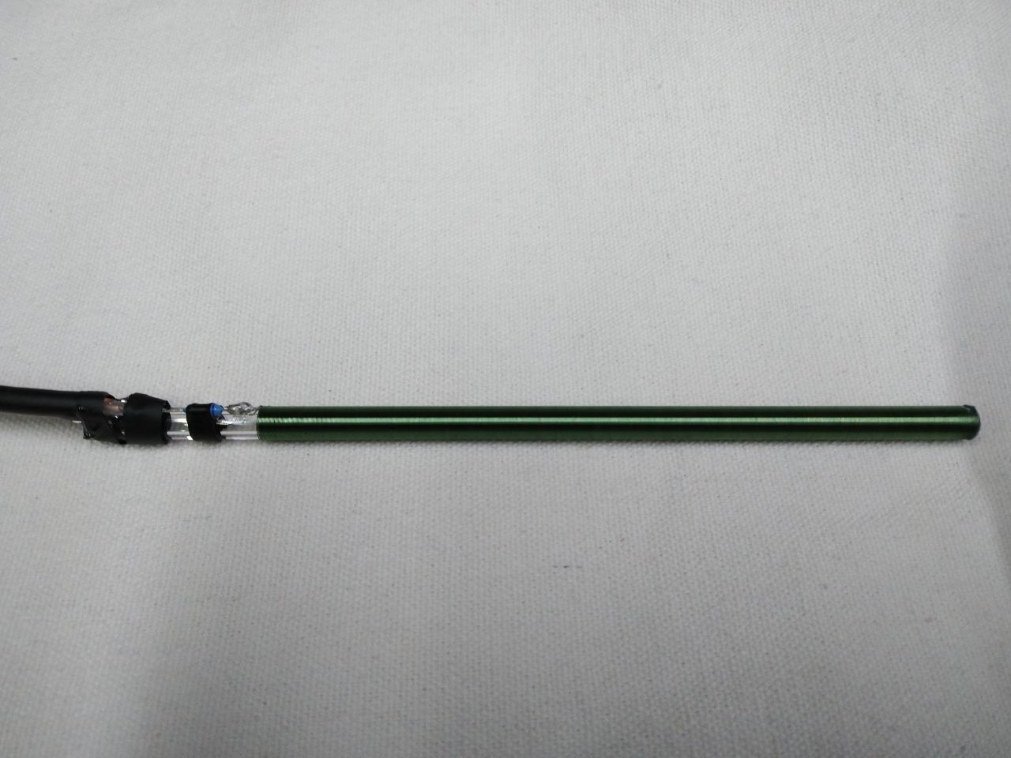
Design gallery/IMG_20190629_211728_20190701_184130006.jpg
