DmitriyMakhnovskiy/Digital_BH-meter_NI_DAQ/Design gallery/IMG_20190629_211758_20190701_184130777.jpg

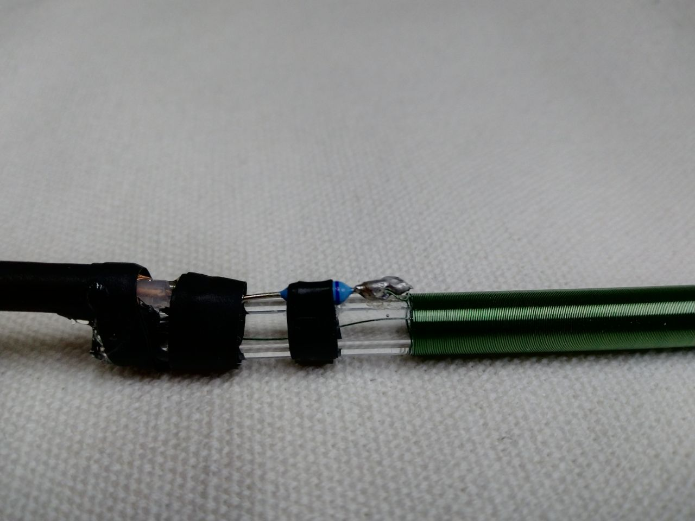
Design gallery/IMG_20190629_211758_20190701_184130777.jpg
