DmitriyMakhnovskiy/Digital_BH-meter_NI_DAQ/Design gallery/IMG_20190629_215902_20190701_184131562.jpg

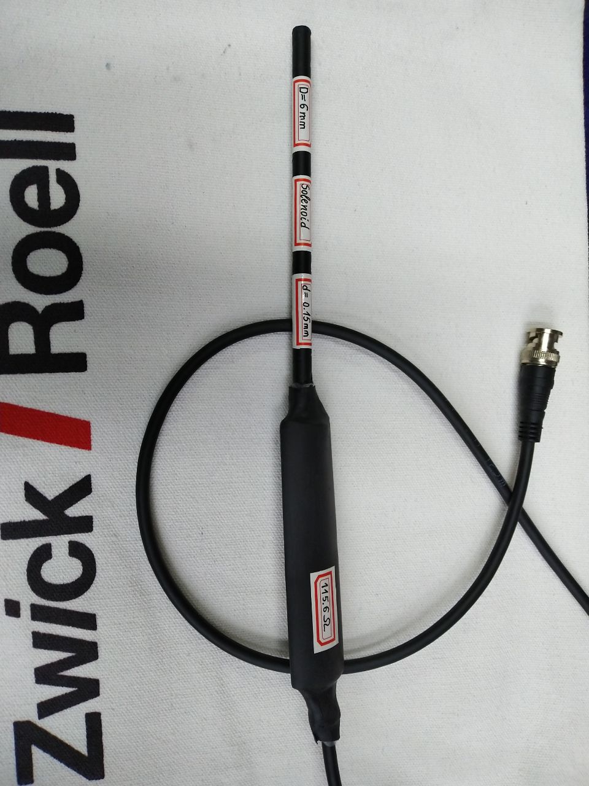
Design gallery/IMG_20190629_215902_20190701_184131562.jpg
