DmitriyMakhnovskiy/Digital_BH-meter_NI_DAQ/Design gallery/IMG_20190629_215912_20190701_184133267.jpg

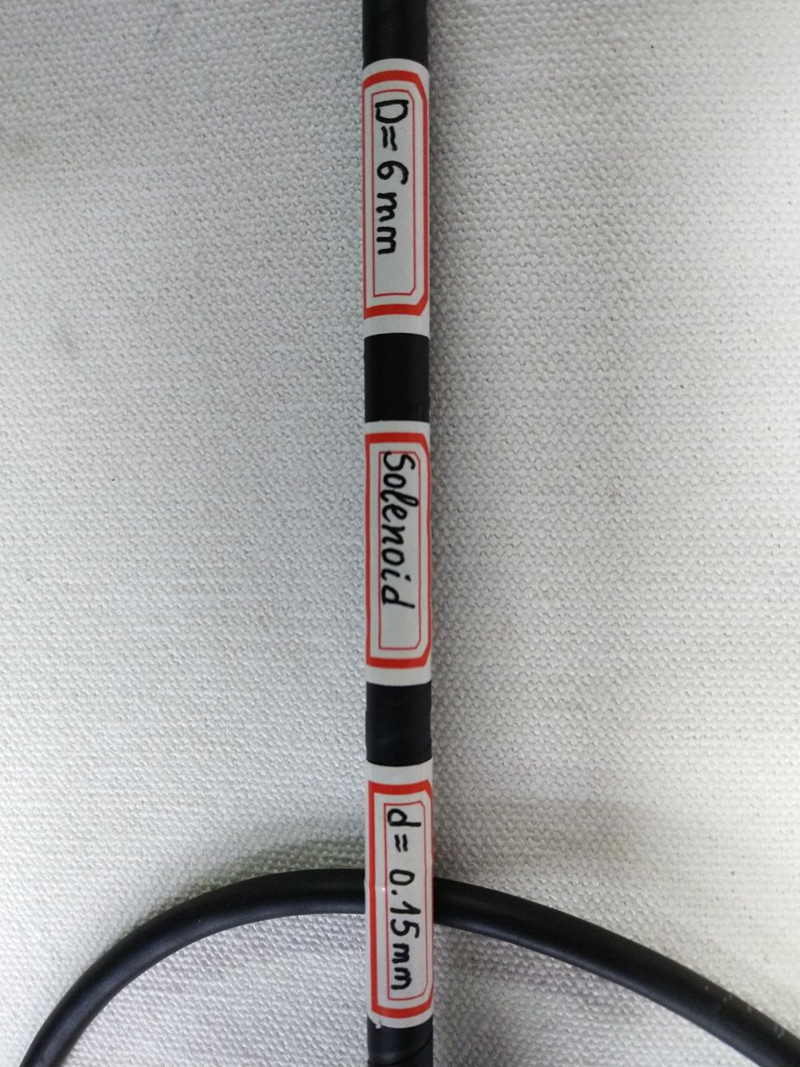
Design gallery/IMG_20190629_215912_20190701_184133267.jpg
