DmitriyMakhnovskiy/Digital_BH-meter_NI_DAQ/Design gallery/IMG_20190630_190041_20190701_181841828.jpg

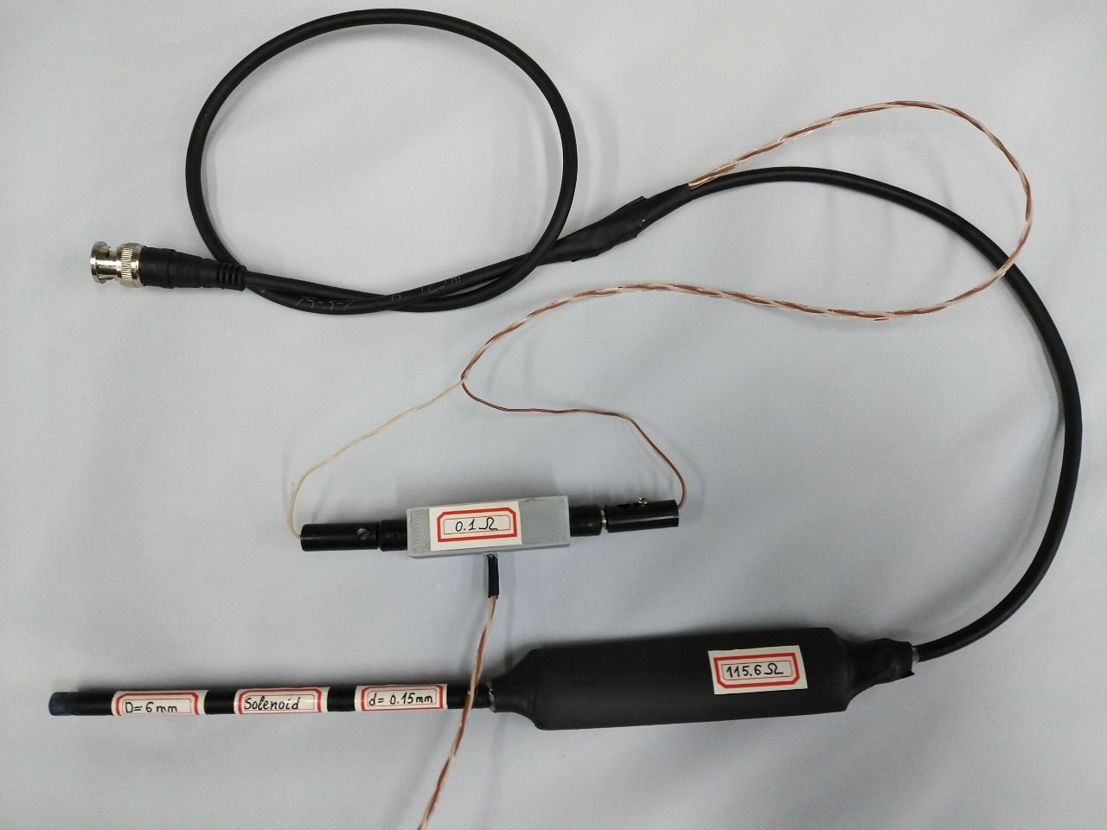
Design gallery/IMG_20190630_190041_20190701_181841828.jpg
