DmitriyMakhnovskiy/Digital_BH-meter_NI_DAQ/Design gallery/IMG_20190630_190854_20190701_181842208.jpg

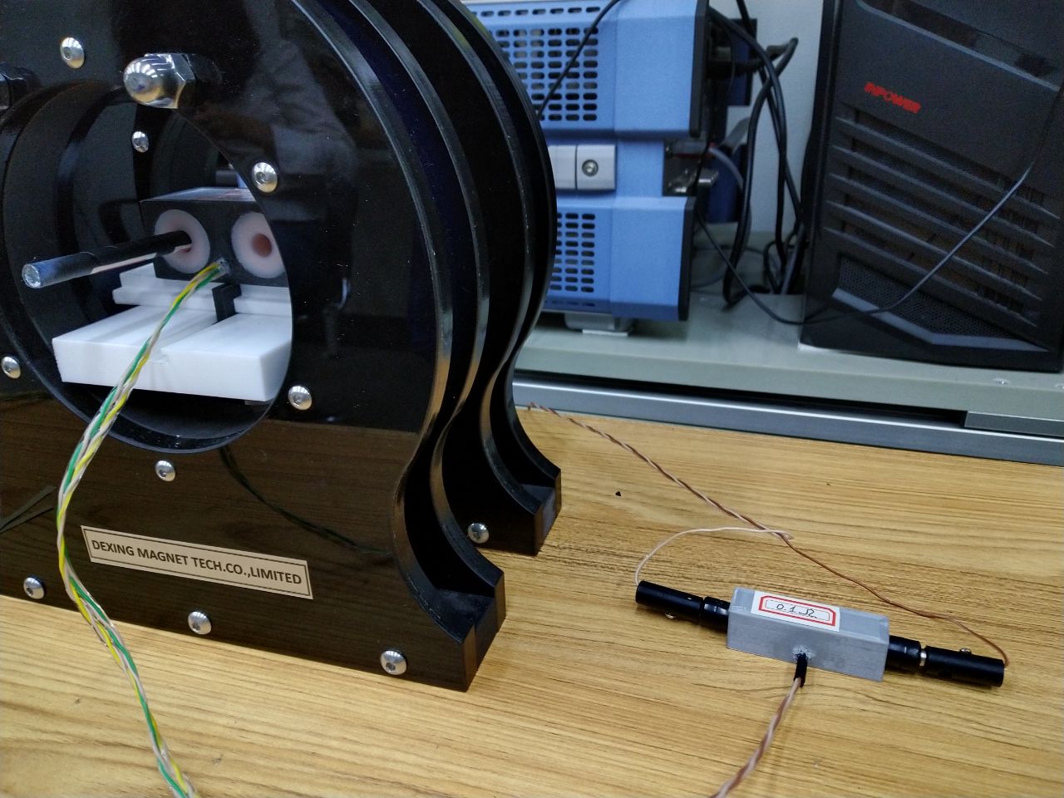
Design gallery/IMG_20190630_190854_20190701_181842208.jpg
