DmitriyMakhnovskiy/Digital_BH-meter_NI_DAQ/Design gallery/IMG_20190630_192938_20190701_181841261.jpg

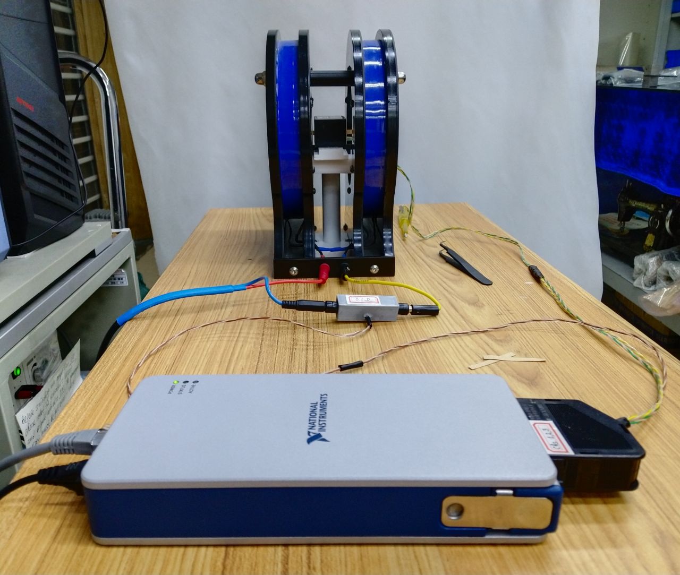
Design gallery/IMG_20190630_192938_20190701_181841261.jpg
