DmitriyMakhnovskiy/Digital_BH-meter_NI_DAQ/Design gallery/IMG_20190630_193218_20190701_181840187.jpg

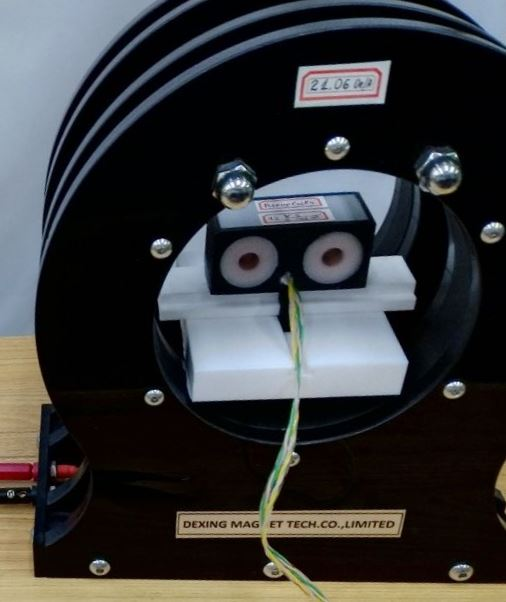
Design gallery/IMG_20190630_193218_20190701_181840187.jpg
