DmitriyMakhnovskiy/Digital_BH-meter_NI_DAQ/Design gallery/WeChat Image_20190620201118.png

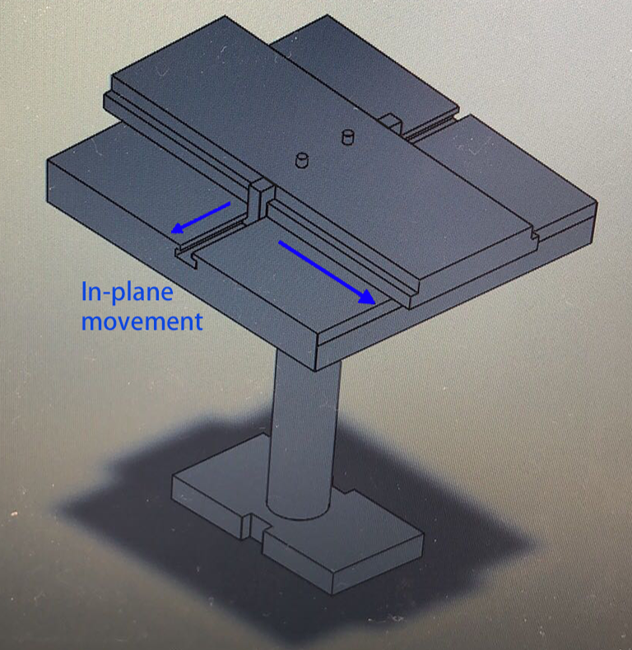
Design gallery/WeChat Image_20190620201118.png
