DmitriyMakhnovskiy/Digital_BH-meter_NI_DAQ/Design gallery/WeChat Image_20190714104830.jpg

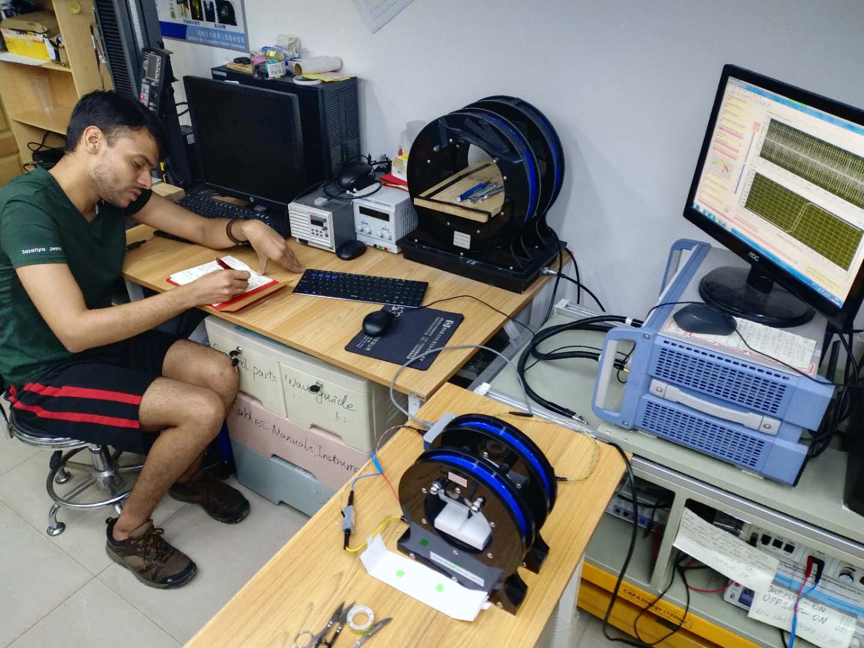
Design gallery/WeChat Image_20190714104830.jpg
