DmitriyMakhnovskiy/Digital_BH-meter_NI_DAQ/Pickup coil design and selection of the devices/20181113_134531.jpg

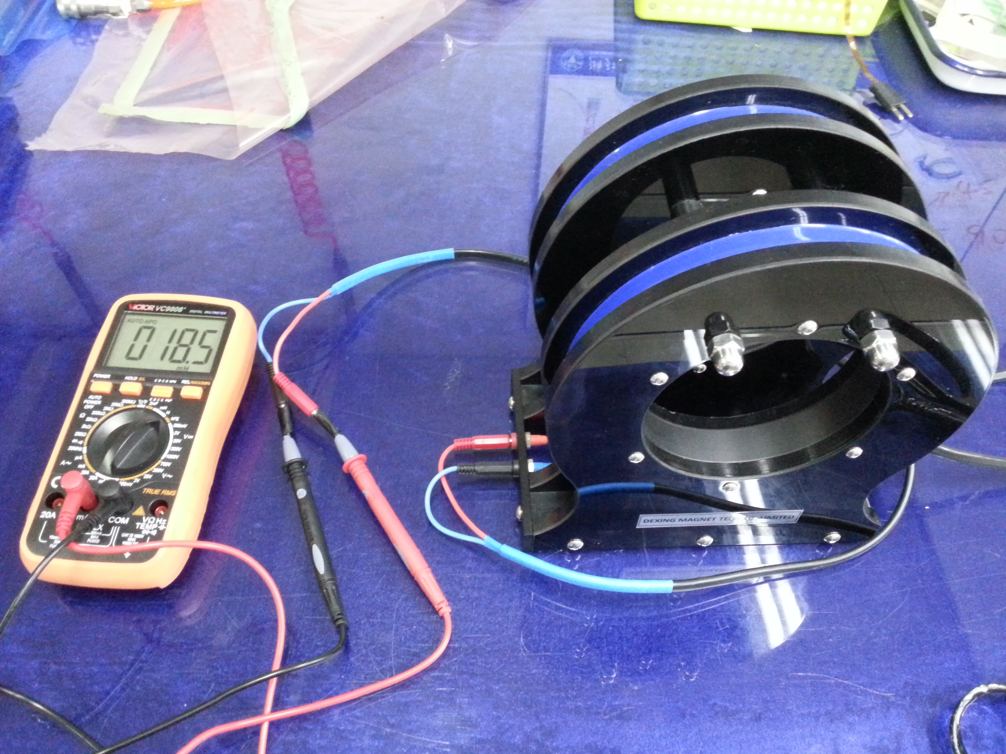
Pickup coil design and selection of the devices/20181113_134531.jpg
