DmitriyMakhnovskiy/Digital_BH-meter_NI_DAQ/Pickup coil design and selection of the devices/20181113_134545.jpg

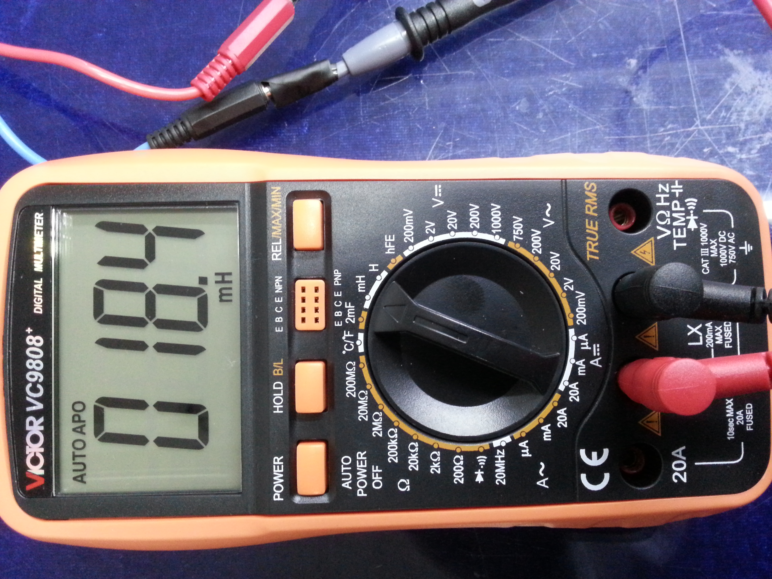
Pickup coil design and selection of the devices/20181113_134545.jpg
