DmitriyMakhnovskiy/Digital_BH-meter_NI_DAQ/Pickup coil design and selection of the devices/Large coil/capacitor.jpg

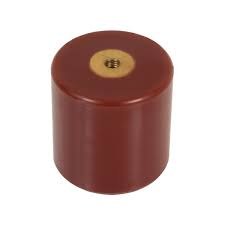
Pickup coil design and selection of the devices/Large coil/capacitor.jpg
