DmitriyMakhnovskiy/Digital_BH-meter_NI_DAQ/Pickup coil design and selection of the devices/Calibration of Helmholtz coils_by Rita.pdf

## Reports on the coils

2018.10.13

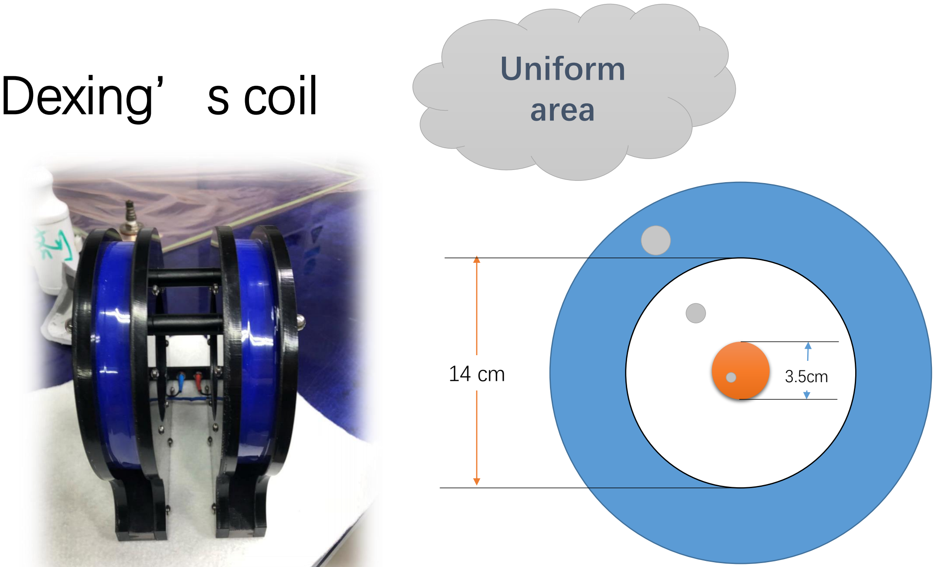
[picture p114: figure]
Dexing’s coil; Uniform; area
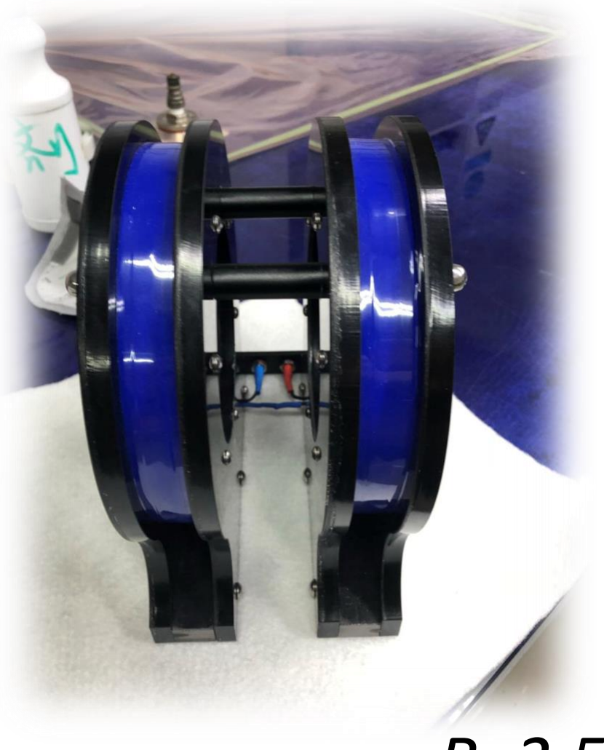
[picture p115: figure]

R=2.5Ω

Dexing’s coil-Oe / A

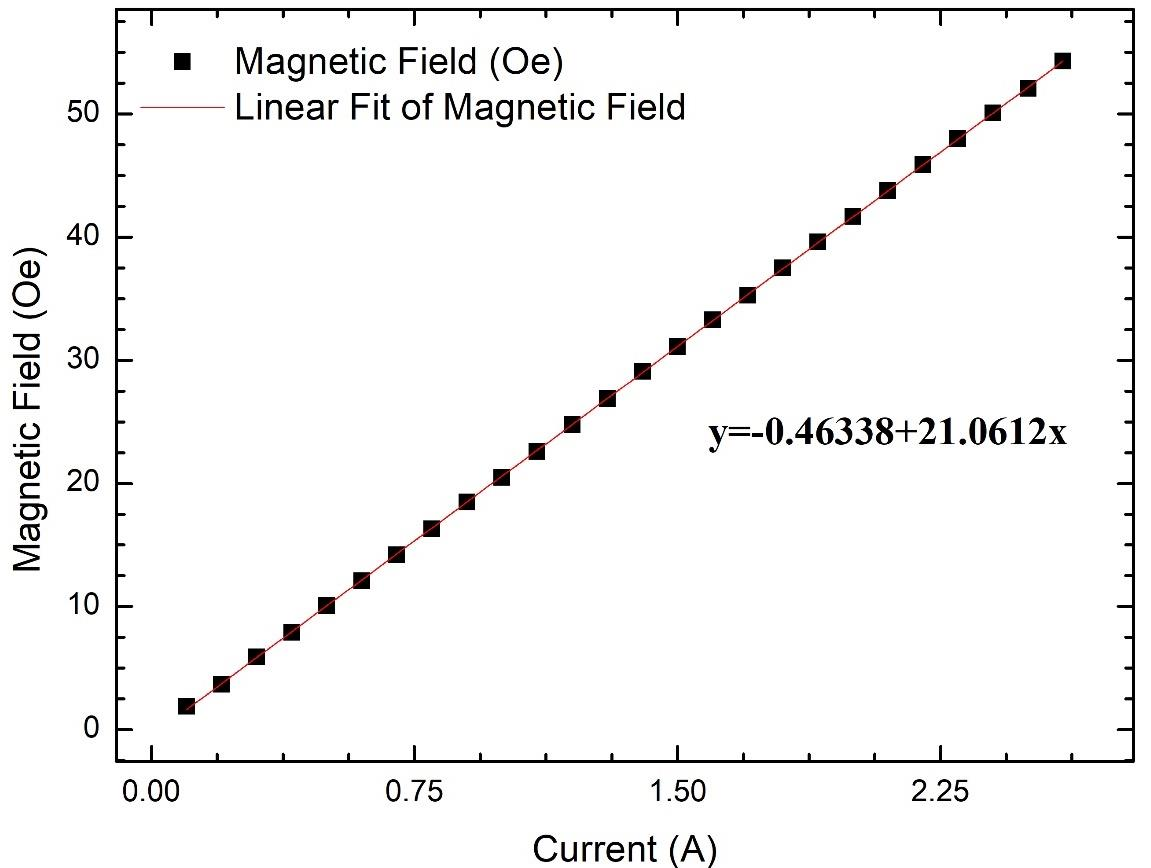
[picture p116: figure]

B
I

= 21.0612 Oe/A

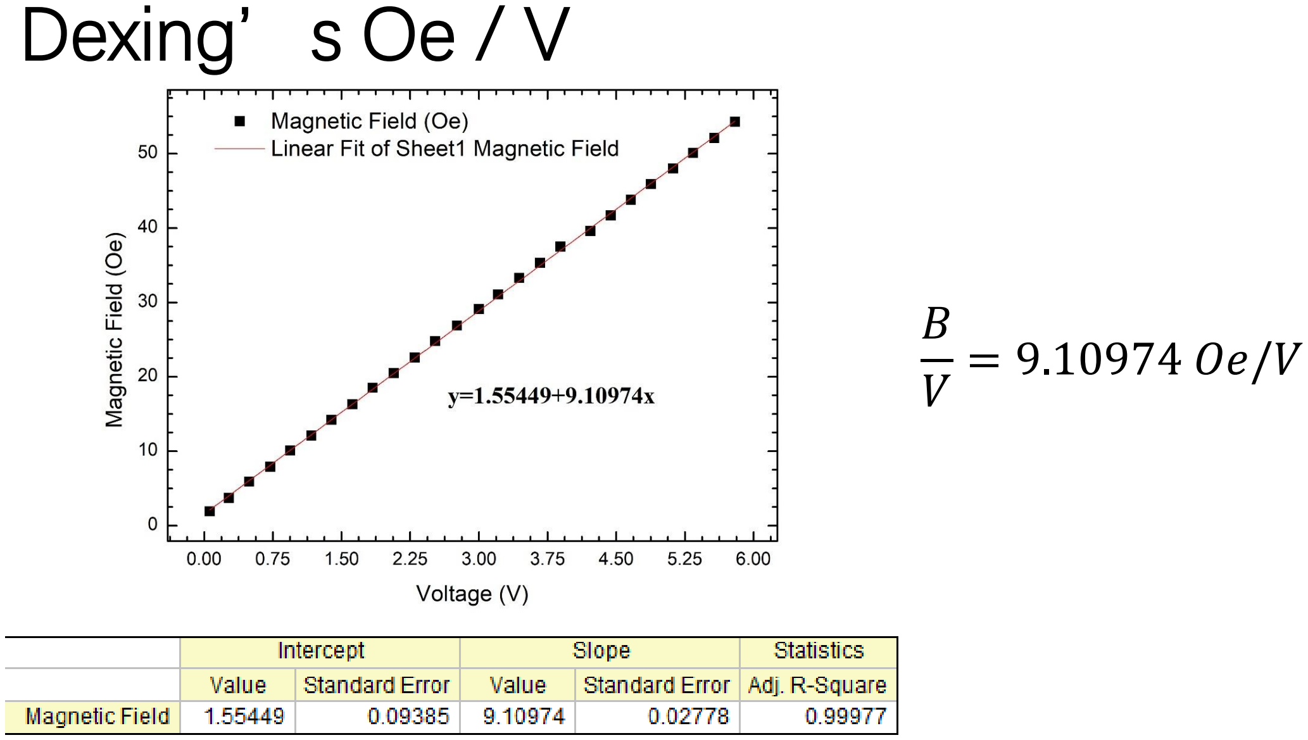
[picture p117: page 4]

Dexing’s Oe / V

B
V

= 9.10974 Oe/V

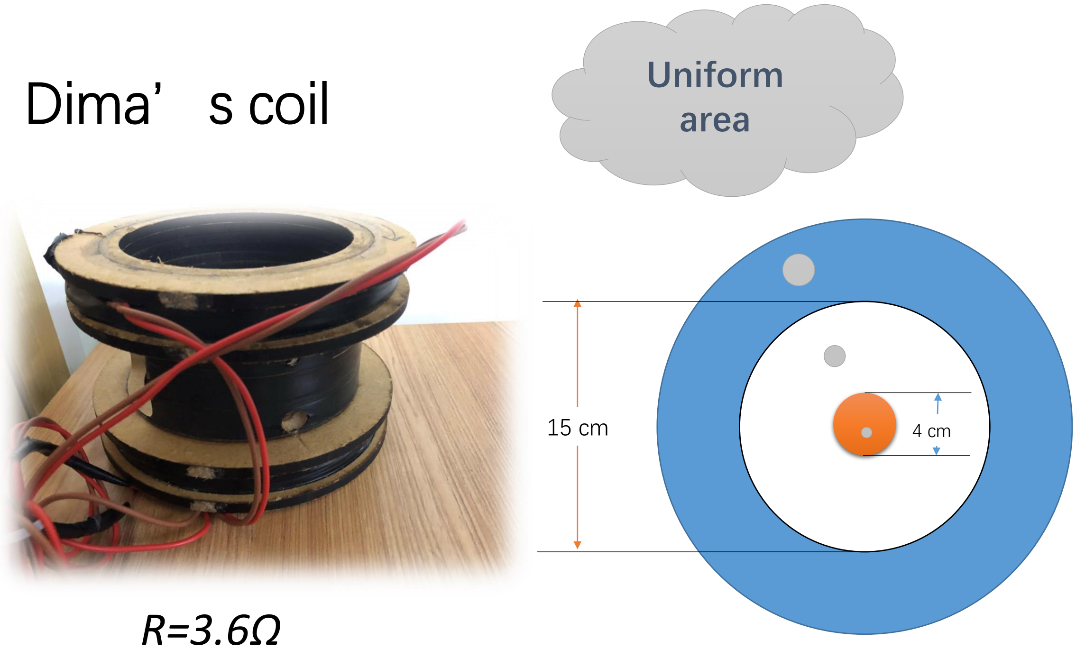
[picture p118: figure]
Dima’s coil; Uniform; area

Dima’s coil-Oe / A

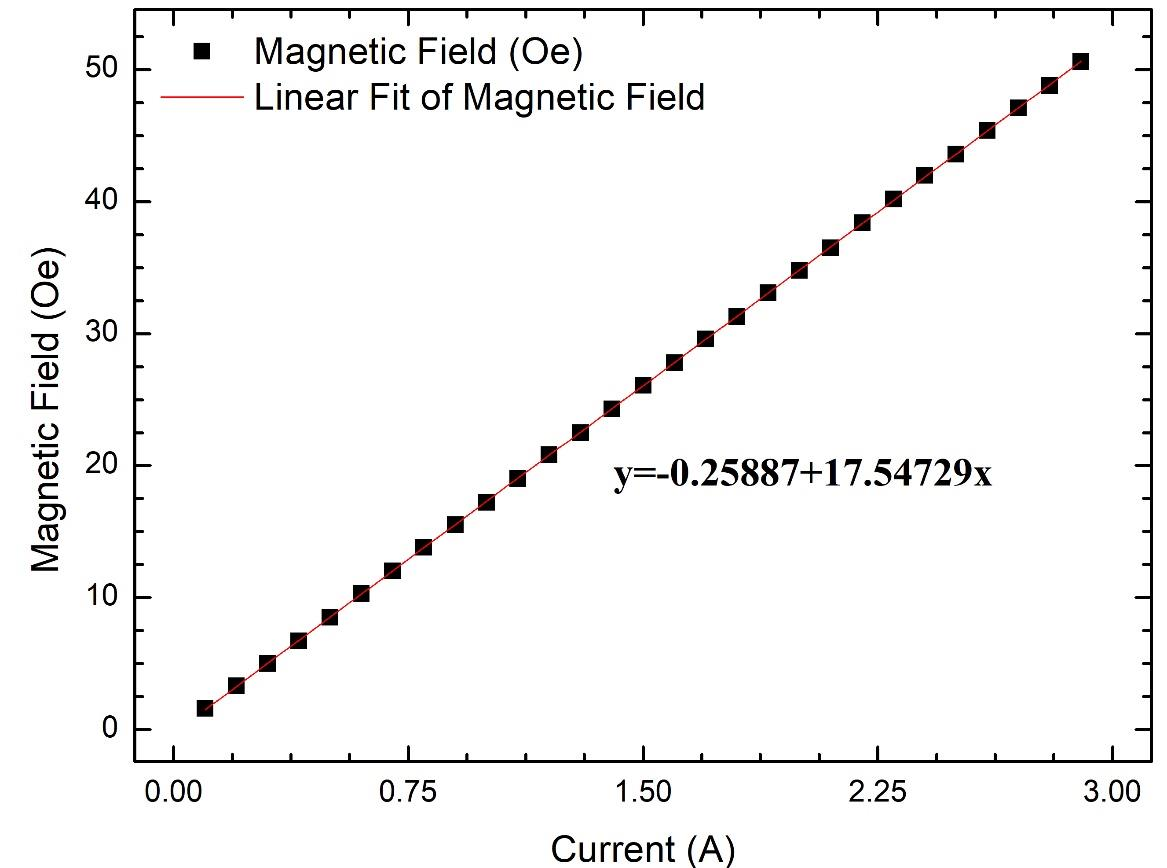
[picture p119: figure]

B
I

= 17.54729 Oe/A

Dima’s coil-Oe / V

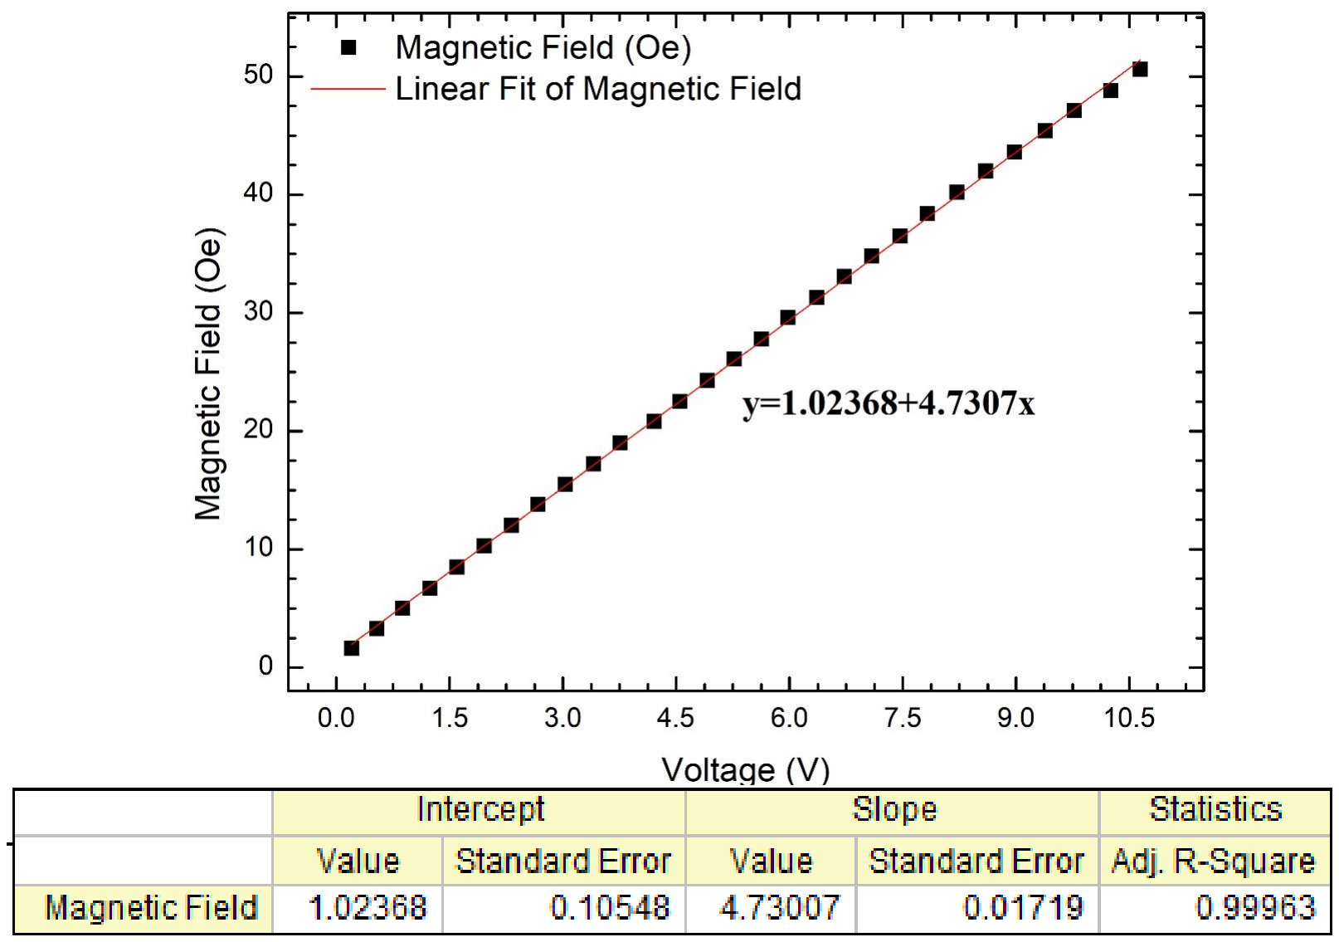
[picture p120: figure]

B
V

= 4.73007 Oe/V
