DmitriyMakhnovskiy/Digital_BH-meter_NI_DAQ/(list of files, drawings)

Other design files:
Design gallery/Bistable wire.opj
Design gallery/Circular wire.opj
Design gallery/Circular wire_high frequency.opj
Pickup coil design and selection of the devices/Large coil/Pickup voltage.opj
Pickup coil design and selection of the devices/Large coil/Resonance capacitance.opj
Pickup coil design and selection of the devices/Large coil/Voltage across the capacitor.opj
Pickup coil design and selection of the devices/Small coil/Excitation_current.opj
Pickup coil design and selection of the devices/Small coil/Pickup_voltage_AWG-38.opj
Pickup coil design and selection of the devices/Small coil/Pickup_voltage_AWG-40.opj
Pickup coil design and selection of the devices/Small coil/Scanning_field.opj
